icl-rocketry/Ricardo-PickleRick/Hardware/PickleRickv3.step

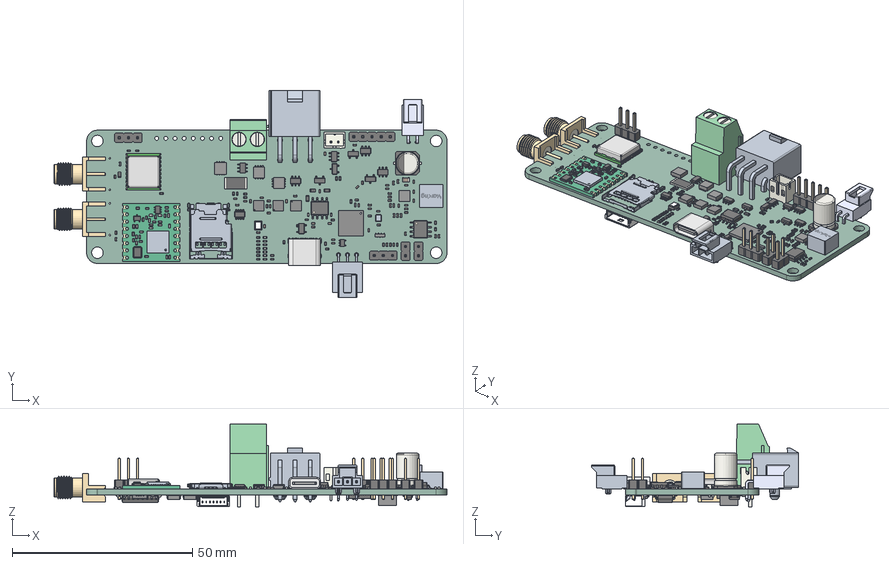
[picture p1: CAD file, 2026-01-28]
Hardware/PickleRickv3.step
109.0 x 57.4 x 23.0 mm
C_0402_1005Metric x 63
L_0402_1005Metric x 3
R_0402_1005Metric x 41
NX2016SA-40M-STD-CZS-3
LED_0402_1005Metric x 17
AL6050
C_0805_2012Metric
ASSEMBLY x 15
SOT_143
MAX-M8Q
CP_Elec_63x99
PinHeader_1x02_P254mm_Vertical x 2
R_0603_1608Metric x 4
SMA_Molex_73251-1153_EdgeMount_Horizontal x 2
SOT_23 x 5
PinHeader_1x03_P254mm_Vertical x 2
SOT_23_8
SOIC_8_39x49mm_P127mm x 2
PinHeader_1x05_P254mm_Vertical
LIS3DH
TSOT_23_6 x 5
RFM95W LoRa v15
ESP32-S3
MMC5983MA x 2
JST_B2B_PH_K
SOT_353_SC_70_5
ST1W008S4TR2000
TerminalBlock_Phoenix_MKDS_3_2_508_1x02_P508mm_Horizontal
DPS368XTSA1
R_2512_6332Metric
QFN-28-1EP_6x6mm_Pitch0.65mm
TO_277B_sp x 4
SOP_16_44x104mm_P127mm
RGV16
PickleRick_PCB
