icl-rocketry/Ricardo-PickleRick/PickleRick.step

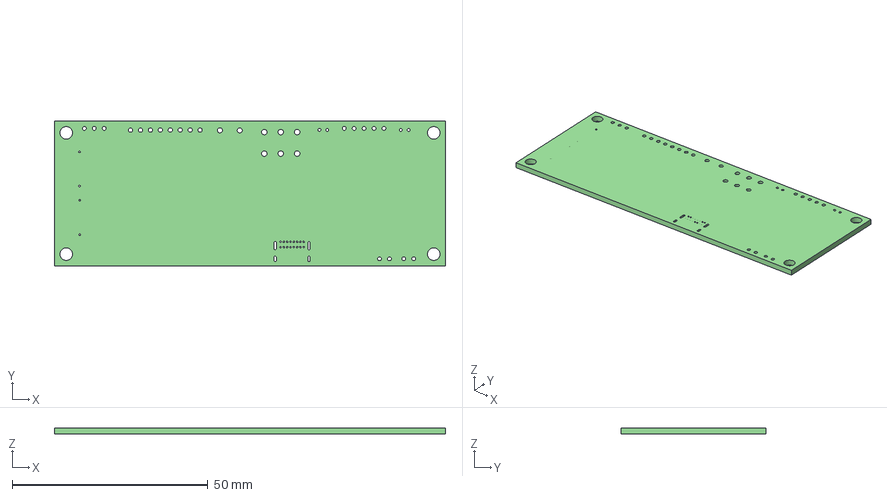
[picture p2: CAD file, 2022-03-22]
PickleRick.step
100.0 x 37.0 x 1.60 mm
