icl-rocketry/Ricardo-PickleRick/Hardware/PickleRick.kicad_pcb

## KiCad design Hardware/PickleRick.kicad_pcb (2026-06-24)

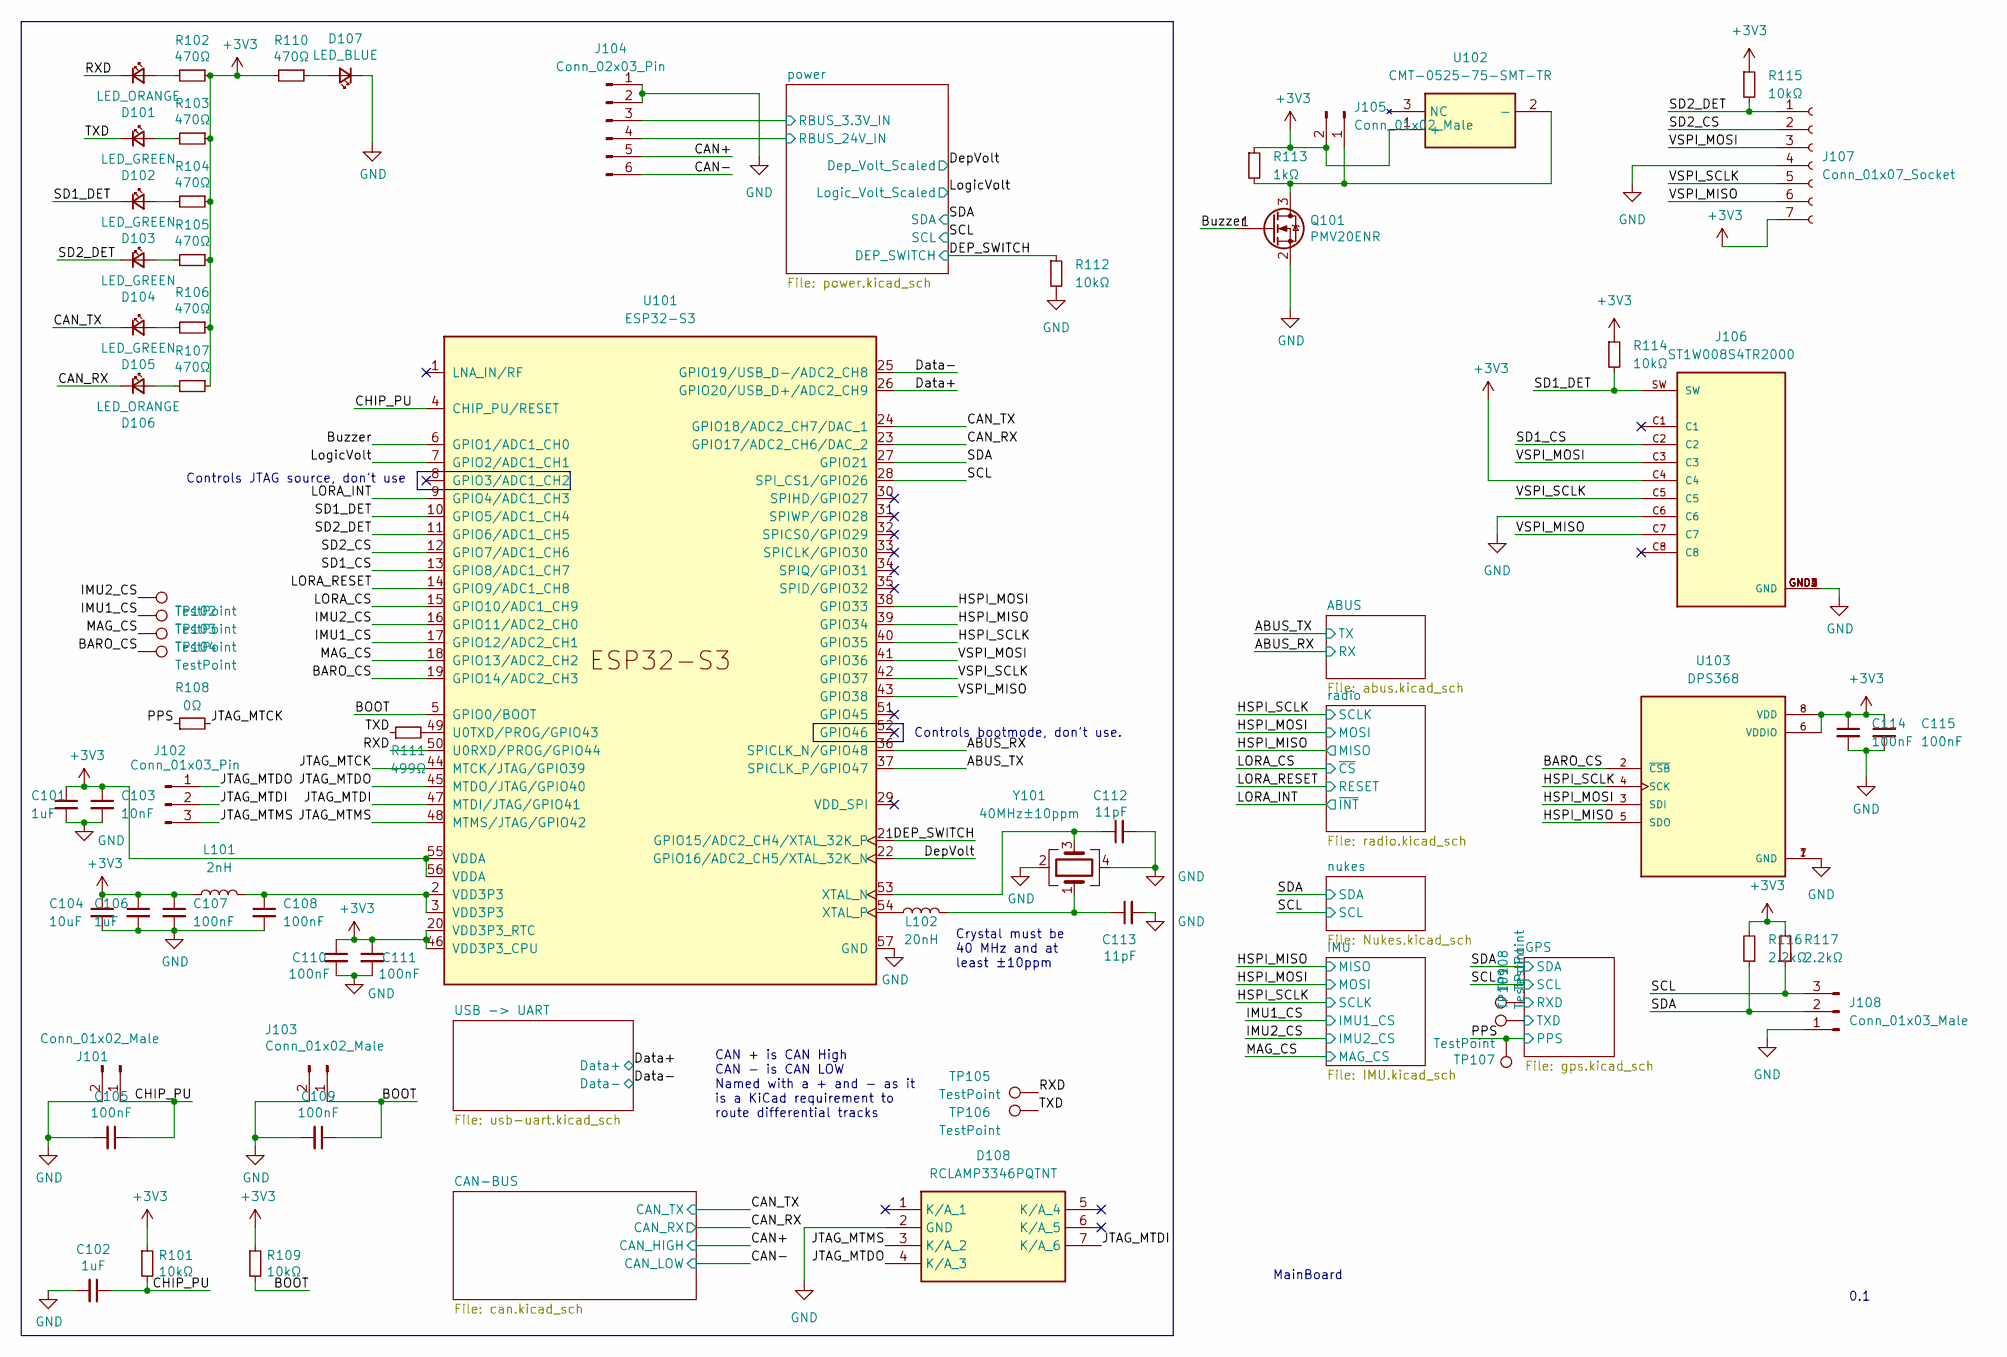
[picture p3: schematic PickleRick.kicad_sch]

Parts:
C101, C102, C106: 1uF; C_0402_1005Metric
C103: 10nF; C_0402_1005Metric
C104: 10uF; C_0402_1005Metric
C105, C107, C108, C109, C110, C111, C114, C115: 100nF; C_0402_1005Metric
C112, C113: 11pF; C_0402_1005Metric
D101, D106: LED_ORANGE; LED_0402_1005Metric
D102, D103, D104, D105: LED_GREEN; LED_0402_1005Metric
D107: LED_BLUE; LED_0402_1005Metric
D108: RCLAMP3346PQTNT; Mouser Part Number 947-RCLAMP3346PQTNT
J101, J103: Conn_01x02_Male; PinHeader_1x02_P2.54mm_Vertical
J102: Conn_01x03_Pin; PinHeader_1x03_P2.54mm_Vertical
J104: Conn_02x03_Pin; Molex_Mini-Fit_Jr_5566-06A_2x03_P4.20mm_Vertical
J105: Conn_01x02_Male; JST_PH_B2B-PH-K_1x02_P2.00mm_Vertical
J106: ST1W008S4TR2000; JAE_ST1W008S4TR2000; PARTREV 1
J107: Conn_01x07_Socket; Molex_Pico-Clasp_202396-0707_1x07-1MP_P1.00mm_Horizontal
J108: Conn_01x03_Male; PinHeader_1x03_P2.54mm_Vertical
L101: 2nH; L_0402_1005Metric
L102: 20nH; L_0402_1005Metric
Q101: PMV20ENR; SOT-23
R101, R109, R112, R114, R115: 10kΩ; R_0402_1005Metric
R102, R103, R104, R105, R106, R107, R110: 470Ω; R_0402_1005Metric
R108: 0Ω; R_0402_1005Metric
R111: 499Ω; R_0402_1005Metric
R113: 1kΩ; R_0402_1005Metric
R116, R117: 2.2kΩ; R_0402_1005Metric
TP101, TP102, TP103, TP104, TP105, TP106, TP107, TP108, TP109: TestPoint; TestPoint_Pad_D1.0mm
U101: ESP32-S3; QFN40P700X700X90-57N
U102: CMT-0525-75-SMT-TR; CMT052575SMTTR; Manufacturer_Part_Number CMT-0525-75-SMT-TR; Mouser Part Number 490-CMT-0525-75SMTTR
U103: DPS368; XDCR_DPS310
Y101: 40MHz±10ppm; Crystal_SMD_2016-4Pin_2.0x1.6mm; MPN R940000171

Connections:
+3V3: C101.1, C103.1, C104.1, C106.1, C107.1, C110.1, C111.1, C114.1, C115.1, J105.2, J106.C4, J107.7, L101.1, R101.1, R102.1, R103.1, R104.1, R105.1, R106.1, R107.1, R109.1, R110.2, R113.1, R114.1, R115.1, R116.2, R117.2, U101.20 (VDD3P3_RTC), U101.46 (VDD3P3_CPU), U101.55 (VDDA), U101.56 (VDDA), U102.1 (+), U103.6 (VDDIO), U103.8 (VDD); also elsewhere on the board
/ABUS_RX: U101.36 (SPICLK_N/GPIO48); also elsewhere on the board
/ABUS_TX: U101.37 (SPICLK_P/GPIO47); also elsewhere on the board
/BARO_CS: TP104.1, U101.19 (GPIO14/ADC2_CH3), U103.2 (~CSB)
/BOOT: C109.1, J103.1, R109.2, U101.5 (GPIO0/BOOT)
/Buzzer: Q101.1 (G), U101.6 (GPIO1/ADC1_CH0)
/CAN+: J104.5; also elsewhere on the board
/CAN-: J104.6; also elsewhere on the board
/CAN_RX: D106.1 (K), U101.23 (GPIO17/ADC2_CH6/DAC_2); also elsewhere on the board
/CAN_TX: D105.1 (K), U101.24 (GPIO18/ADC2_CH7/DAC_1); also elsewhere on the board
/CHIP_PU: C102.1, C105.1, J101.1, R101.2, U101.4 (CHIP_PU/RESET)
/DEP_SWITCH: R112.1, U101.21 (GPIO15/ADC2_CH4/XTAL_32K_P); also elsewhere on the board
/Data+: U101.26 (GPIO20/USB_D+/ADC2_CH9); also elsewhere on the board
/Data-: U101.25 (GPIO19/USB_D-/ADC2_CH8); also elsewhere on the board
/DepVolt: U101.22 (GPIO16/ADC2_CH5/XTAL_32K_N); also elsewhere on the board
/GPS/RXD: TP108.1; also elsewhere on the board
/GPS/TXD: TP109.1; also elsewhere on the board
/HSPI_MISO: U101.39 (GPIO34), U103.5 (SDO); also elsewhere on the board
/HSPI_MOSI: U101.38 (GPIO33), U103.3 (SDI); also elsewhere on the board
/HSPI_SCLK: U101.40 (GPIO35), U103.4 (SCK); also elsewhere on the board
/IMU1_CS: TP102.1, U101.17 (GPIO12/ADC2_CH1); also elsewhere on the board
/IMU2_CS: TP101.1, U101.16 (GPIO11/ADC2_CH0); also elsewhere on the board
/JTAG_MTCK: R108.2, U101.44 (MTCK/JTAG/GPIO39)
/JTAG_MTDI: D108.7 (K/A_6), J102.2, U101.47 (MTDI/JTAG/GPIO41)
/JTAG_MTDO: D108.4 (K/A_3), J102.1, U101.45 (MTDO/JTAG/GPIO40)
/JTAG_MTMS: D108.3 (K/A_2), J102.3, U101.48 (MTMS/JTAG/GPIO42)
/LORA_CS: U101.15 (GPIO10/ADC1_CH9); also elsewhere on the board
/LORA_INT: U101.9 (GPIO4/ADC1_CH3); also elsewhere on the board
/LORA_RESET: U101.14 (GPIO9/ADC1_CH8); also elsewhere on the board
/LogicVolt: U101.7 (GPIO2/ADC1_CH1); also elsewhere on the board
/MAG_CS: TP103.1, U101.18 (GPIO13/ADC2_CH2); also elsewhere on the board
/PPS: R108.1, TP107.1; also elsewhere on the board
/RXD: D101.1 (K), TP105.1, U101.50 (U0RXD/PROG/GPIO44)
/SCL: J108.3, R117.1, U101.28 (SPI_CS1/GPIO26); also elsewhere on the board
/SD1_CS: J106.C2, U101.13 (GPIO8/ADC1_CH7)
/SD1_DET: D103.1 (K), J106.SW, R114.2, U101.10 (GPIO5/ADC1_CH4)
/SD2_CS: J107.2, U101.12 (GPIO7/ADC1_CH6)
/SD2_DET: D104.1 (K), J107.1, R115.2, U101.11 (GPIO6/ADC1_CH5)
/SDA: J108.2, R116.1, U101.27 (GPIO21); also elsewhere on the board
/TXD: D102.1 (K), R111.1, TP106.1
/VSPI_MISO: J106.C7, J107.6, U101.43 (GPIO38)
/VSPI_MOSI: J106.C3, J107.3, U101.41 (GPIO36)
/VSPI_SCLK: J106.C5, J107.5, U101.42 (GPIO37)
/power/RBUS_3.3V_IN: J104.3; also elsewhere on the board
/power/RBUS_24V_IN: J104.4; also elsewhere on the board
GND: C101.2, C102.2, C103.2, C104.2, C105.2, C106.2, C107.2, C108.2, C109.2, C110.2, C111.2, C112.2, C113.2, C114.2, C115.2, D107.1 (K), D108.2 (GND), J101.2, J103.2, J104.1, J104.2, J106.C6, J106.GND1 (GND), J106.GND2 (GND), J106.GND3 (GND), J106.GND4 (GND), J107.4, J108.1, Q101.2 (S), R112.2, U101.57 (GND), U103.1 (GND), U103.7 (GND), Y101.2, Y101.4; also elsewhere on the board
unnamed: C108.1, L101.2, U101.2 (VDD3P3), U101.3 (VDD3P3)
unnamed: C113.1, L102.2, Y101.1
unnamed: D101.2 (A), R102.2
unnamed: D102.2 (A), R103.2
unnamed: D103.2 (A), R104.2
unnamed: D104.2 (A), R105.2
unnamed: D105.2 (A), R106.2
unnamed: D106.2 (A), R107.2
unnamed: D107.2 (A), R110.1
unnamed: J105.1, Q101.3 (D), R113.2, U102.2 (-)
unnamed: R111.2, U101.49 (U0TXD/PROG/GPIO43)
unnamed: C112.1, U101.53 (XTAL_N), Y101.3
unnamed: L102.1, U101.54 (XTAL_P)

Notes on the sheet:
Controls JTAG source, don't use
CAN + is CAN High CAN - is CAN LOW Named with a + and - as it is a KiCad requirement to route differential tracks
MainBoard
Controls bootmode, don't use.
0.1
Crystal must be 40 MHz and at least ±10ppm

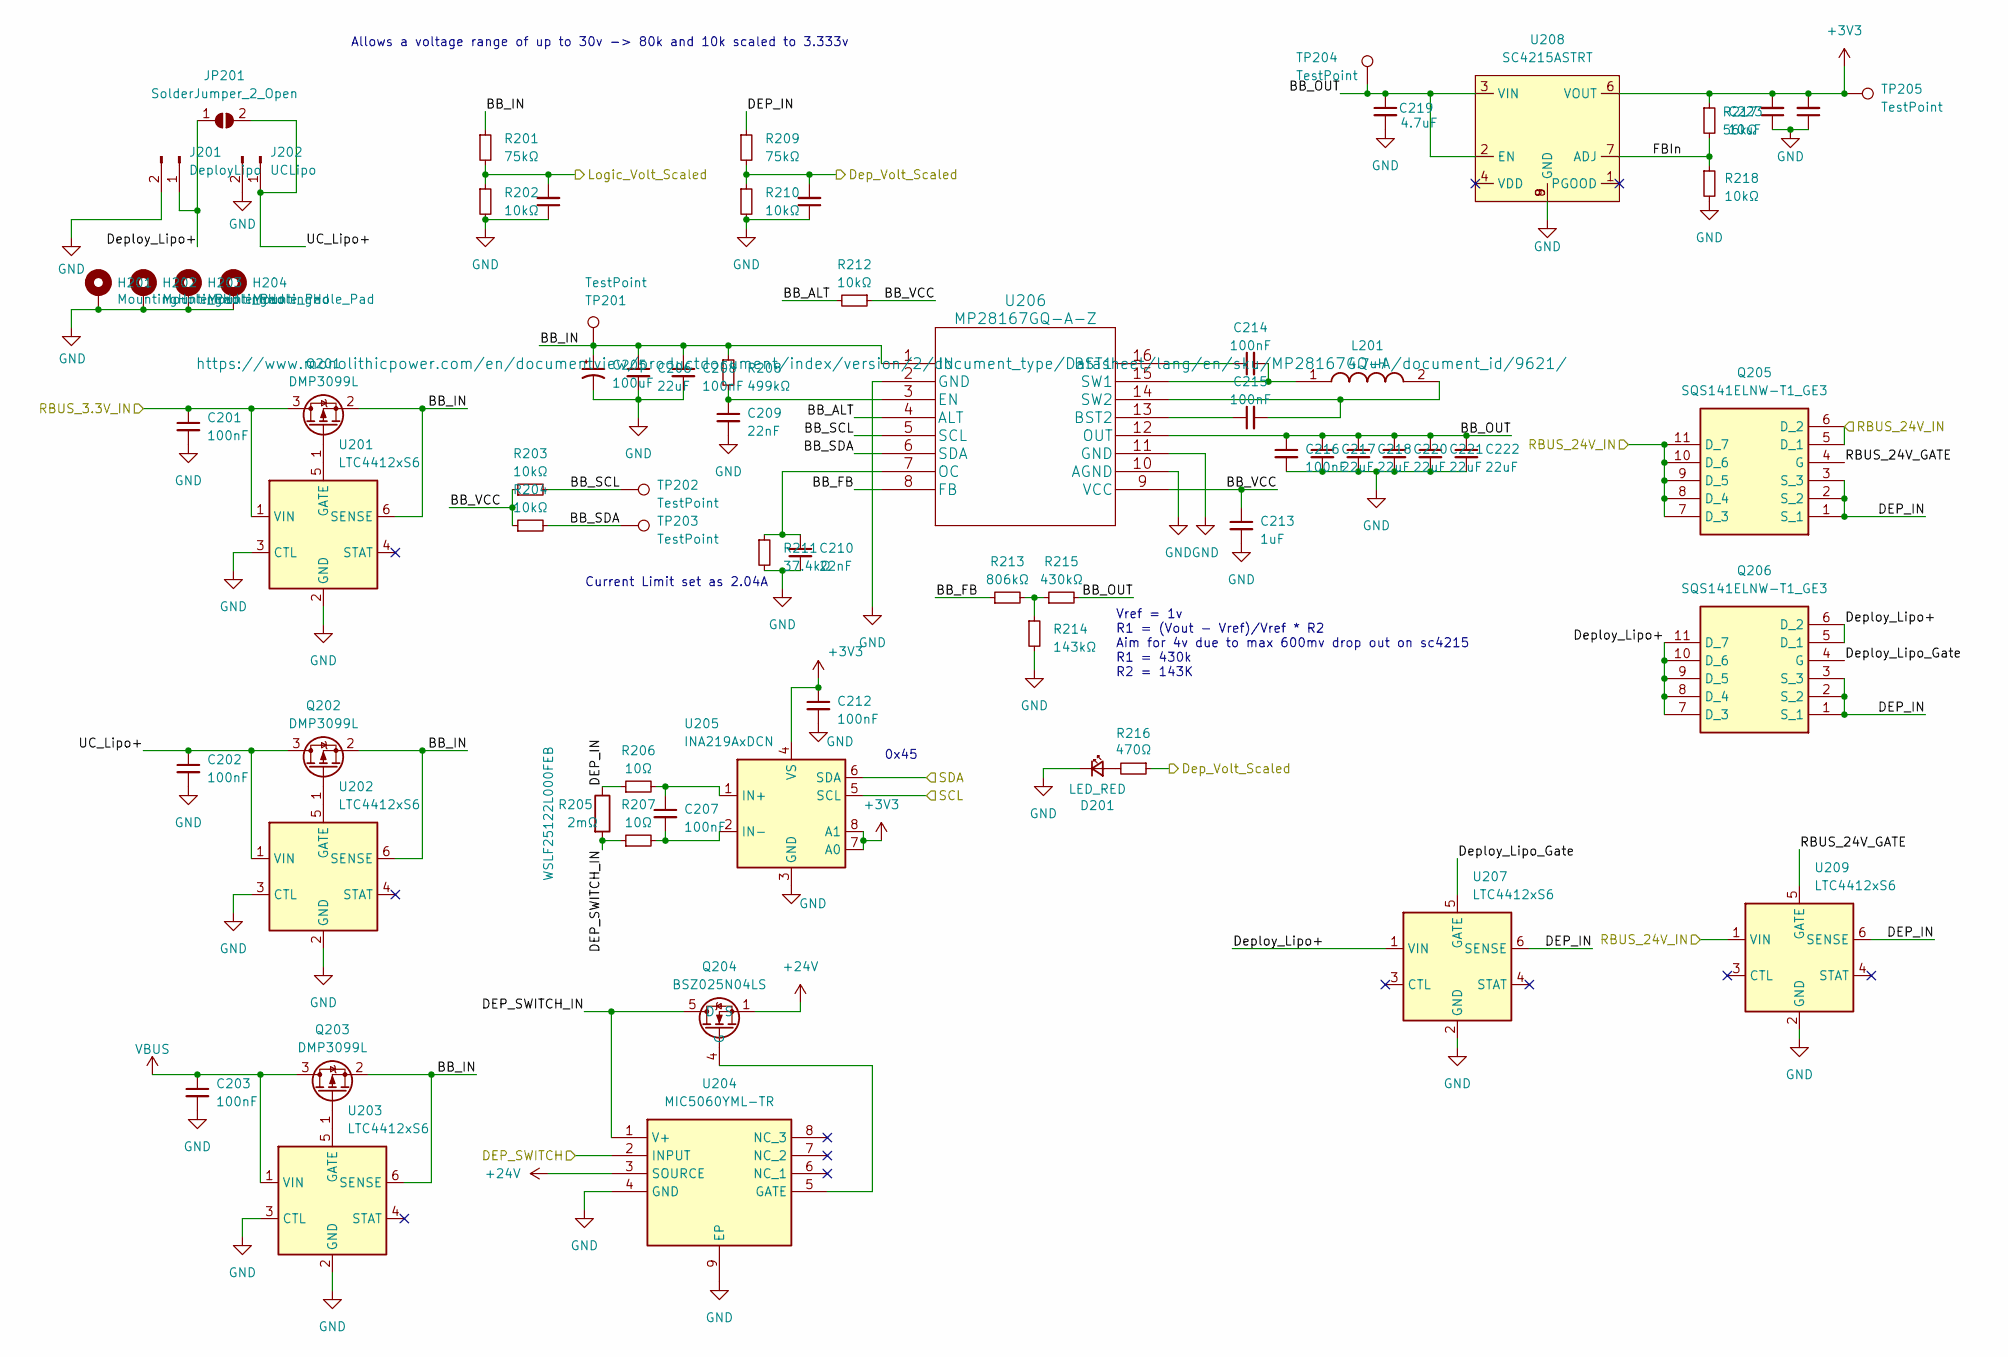
[picture p4: schematic power.kicad_sch]

Parts:
C201, C202, C203, C204, C207, C208, C211, C212, C214, C215, C216, C224: 100nF; C_0402_1005Metric
C205: 100uF; CP_Elec_6.3x9.9
C206: 22uF; C_0805_2012Metric
C209, C210: 22nF; C_0402_1005Metric
C213: 1uF; C_0402_1005Metric
C217, C218, C220, C221, C222: 22uF; C_0402_1005Metric
C219: 4.7uF; C_0402_1005Metric
C223: 10uF; C_0402_1005Metric
D201: LED_RED; LED_0402_1005Metric
H201, H202, H203, H204: MountingHole_Pad; MountingHole_3.2mm_M3_DIN965_Pad
J201: DeployLipo; TerminalBlock_Phoenix_MKDS-3-2-5.08_1x02_P5.08mm_Horizontal
J202: UCLipo; JST_PH_B2B-PH-K_1x02_P2.00mm_Vertical
JP201: SolderJumper_2_Open; SolderJumper-2_P1.3mm_Open_RoundedPad1.0x1.5mm
L201: 4.7uH; MPLAL60504R7; Manufacturer_Part_Number MPL-AL6050-4R7; Mouser Part Number 946-MPL-AL6050-4R7
Q201, Q202, Q203: DMP3099L; SOT-23
Q204: BSZ025N04LS; Manufacturer_Part_Number BSZ025N04LS; Mouser Part Number 726-BSZ025N04LS
Q205, Q206: SQS141ELNW-T1_GE3; SQS850ENT1_GE3; Manufacturer_Part_Number SQS141ELNW-T1_GE3; Mouser Part Number 78-SQS141ELNW-T1_GE3
R201, R209: 75kΩ; R_0402_1005Metric
R202, R203, R204, R210, R212, R218: 10kΩ; R_0402_1005Metric
R205: 2mΩ; R_2512_6332Metric_Pad1.40x3.35mm_HandSolder; Part Number WSLF25122L000FEB
R206, R207: 10Ω; R_0402_1005Metric
R208: 499kΩ; R_0402_1005Metric
R211: 37.4kΩ; R_0402_1005Metric
R213: 806kΩ; R_0402_1005Metric
R214: 143kΩ; R_0402_1005Metric
R215: 430kΩ; R_0402_1005Metric
R216: 470Ω; R_0402_1005Metric
R217: 56kΩ; R_0402_1005Metric
TP201, TP204, TP205: TestPoint; TestPoint_Pad_D2.0mm
TP202, TP203: TestPoint; TestPoint_Pad_D1.0mm
U201, U202, U203, U207, U209: LTC4412xS6; TSOT-23-6
U204: MIC5060YML-TR; SON65P300X300X100-9N-D; Manufacturer_Part_Number MIC5060YML-TR; Mouser Part Number 998-MIC5060YMLTR
U205: INA219AxDCN; SOT-23-8
U206: MP28167GQ-A-Z
U208: SC4215ASTRT; SOIC127P599X175-9N

Connections:
+3V3: C212.1, C223.2, C224.2, R217.1, TP205.1, U205.4 (VS), U205.7 (A0), U205.8 (A1), U208.6 (VOUT); also elsewhere on the board
+24V: Q204.1 (S), Q204.2 (S), Q204.3 (S), Q204.A1 (S), U204.3 (SOURCE); also elsewhere on the board
/DEP_SWITCH: U204.2 (INPUT); also elsewhere on the board
/DepVolt: C211.2, R209.2, R210.1, R216.1; also elsewhere on the board
/LogicVolt: C204.2, R201.2, R202.1; also elsewhere on the board
/SCL: U205.5 (SCL); also elsewhere on the board
/SDA: U205.6 (SDA); also elsewhere on the board
/power/BB_ALT: R212.2, U206.4 (ALT)
/power/BB_FB: R213.1, U206.8 (FB)
/power/BB_IN: C205.1, C206.1, C208.1, Q201.2 (S), Q202.2 (S), Q203.2 (S), R201.1, R208.1, TP201.1, U201.6 (SENSE), U202.6 (SENSE), U203.6 (SENSE), U206.1 (IN)
/power/BB_OUT: C216.1, C217.1, C218.1, C219.1, C220.1, C221.1, C222.1, R215.2, TP204.1, U206.12 (OUT), U208.2 (EN), U208.3 (VIN)
/power/BB_SCL: R203.2, TP202.1, U206.5 (SCL)
/power/BB_SDA: R204.2, TP203.1, U206.6 (SDA)
/power/BB_VCC: C213.1, R203.1, R204.1, R212.1, U206.9 (VCC)
/power/DEP_IN: Q205.1 (S_1), Q205.2 (S_2), Q205.3 (S_3), Q206.1 (S_1), Q206.2 (S_2), Q206.3 (S_3), R205.1, R206.1, R209.1, U207.6 (SENSE), U209.6 (SENSE)
/power/DEP_SWITCH_IN: Q204.5 (D), Q204.6 (D), Q204.7 (D), Q204.8 (D), Q204.A5 (D), R205.2, R207.1, U204.1 (V+)
/power/Deploy_Lipo+: J201.1, JP201.1 (A), Q206.5 (D_1), Q206.6 (D_2), Q206.7 (D_3), Q206.8 (D_4), Q206.9 (D_5), Q206.10 (D_6), Q206.11 (D_7), U207.1 (VIN)
/power/Deploy_Lipo_Gate: Q206.4 (G), U207.5 (GATE)
/power/FBIn: R217.2, R218.1, U208.7 (ADJ)
/power/RBUS_3.3V_IN: C201.1, Q201.3 (D), U201.1 (VIN); also elsewhere on the board
/power/RBUS_24V_GATE: Q205.4 (G), U209.5 (GATE)
/power/RBUS_24V_IN: Q205.5 (D_1), Q205.6 (D_2), Q205.7 (D_3), Q205.8 (D_4), Q205.9 (D_5), Q205.10 (D_6), Q205.11 (D_7), U209.1 (VIN); also elsewhere on the board
/power/UC_Lipo+: C202.1, J202.1, JP201.2 (B), Q202.3 (D), U202.1 (VIN)
GND: C201.2, C202.2, C203.2, C204.1, C205.2, C206.2, C208.2, C209.2, C210.2, C211.1, C212.2, C213.2, C216.2, C217.2, C218.2, C219.2, C220.2, C221.2, C222.2, C223.1, C224.1, D201.1 (K), H201.1, H202.1, H203.1, H204.1, J201.2, J202.2, R202.2, R210.2, R211.2, R214.2, R218.2, U201.2 (GND), U201.3 (CTL), U202.2 (GND), U202.3 (CTL), U203.2 (GND), U203.3 (CTL), U204.4 (GND), U204.9 (EP), U205.3 (GND), U206.2 (GND), U206.10 (AGND), U206.11 (GND), U207.2 (GND), U208.8 (GND), U208.9 (GND), U209.2 (GND); also elsewhere on the board
unnamed: D201.2 (A), R216.2
unnamed: Q201.1 (G), U201.5 (GATE)
unnamed: Q202.1 (G), U202.5 (GATE)
unnamed: Q203.1 (G), U203.5 (GATE)
unnamed: Q204.4 (G), U204.5 (GATE)
unnamed: R213.2, R214.1, R215.1
unnamed: C207.1, R206.2, U205.1 (IN+)
unnamed: C207.2, R207.2, U205.2 (IN-)
unnamed: C214.1, U206.16 (BST1)
unnamed: C215.1, U206.13 (BST2)
unnamed: C209.1, R208.2, U206.3 (EN)
unnamed: C210.1, R211.1, U206.7 (OC)
unnamed: C214.2, L201.1, U206.15 (SW1)
unnamed: C215.2, L201.2, U206.14 (SW2)
VBUS: C203.1, Q203.3 (D), U203.1 (VIN); also elsewhere on the board

Notes on the sheet:
0x45
Allows a voltage range of up to 30v -> 80k and 10k scaled to 3.333v
Vref = 1v R1 = (Vout - Vref)/Vref * R2 Aim for 4v due to max 600mv drop out on sc4215 R1 = 430k R2 = 143K
Current Limit set as 2.04A

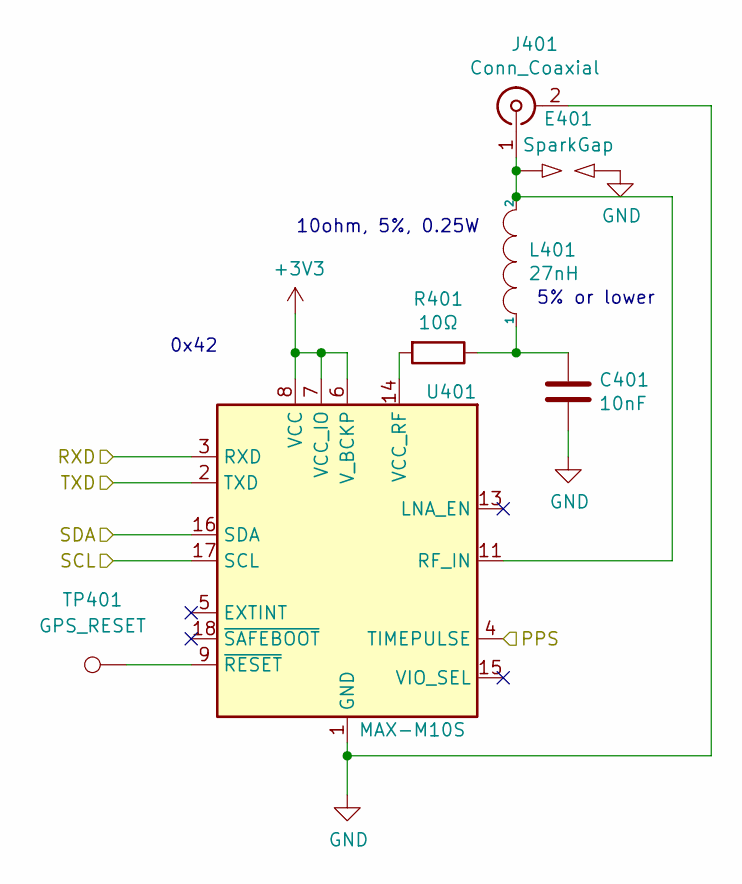
[picture p5: schematic gps.kicad_sch]

Parts:
C401: 10nF; C_0402_1005Metric
E401: SparkGap; Spark_Gap
J401: Conn_Coaxial; SMA_Molex_73251-1153_EdgeMount_Horizontal
L401: 27nH; L_0402_1005Metric; Part LQG15HZ27NH02D
R401: 10Ω; R_0603_1608Metric
TP401: GPS_RESET; TestPoint_Pad_D1.0mm
U401: MAX-M10S; ublox_MAX

Connections:
+3V3: U401.6 (V_BCKP), U401.7 (VCC_IO), U401.8 (VCC); also elsewhere on the board
/GPS/RXD: U401.3 (RXD); also elsewhere on the board
/GPS/TXD: U401.2 (TXD); also elsewhere on the board
/PPS: U401.4 (TIMEPULSE); also elsewhere on the board
/SCL: U401.17 (SCL); also elsewhere on the board
/SDA: U401.16 (SDA); also elsewhere on the board
GND: C401.2, E401.2, J401.2 (Ext), U401.1 (GND), U401.10 (GND), U401.12 (GND); also elsewhere on the board
unnamed: C401.1, L401.1, R401.1
unnamed: E401.1, J401.1 (In), L401.2, U401.11 (RF_IN)
unnamed: R401.2, U401.14 (VCC_RF)
unnamed: TP401.1, U401.9 (~RESET)

Notes on the sheet:
5% or lower
0x42
10ohm, 5%, 0.25W

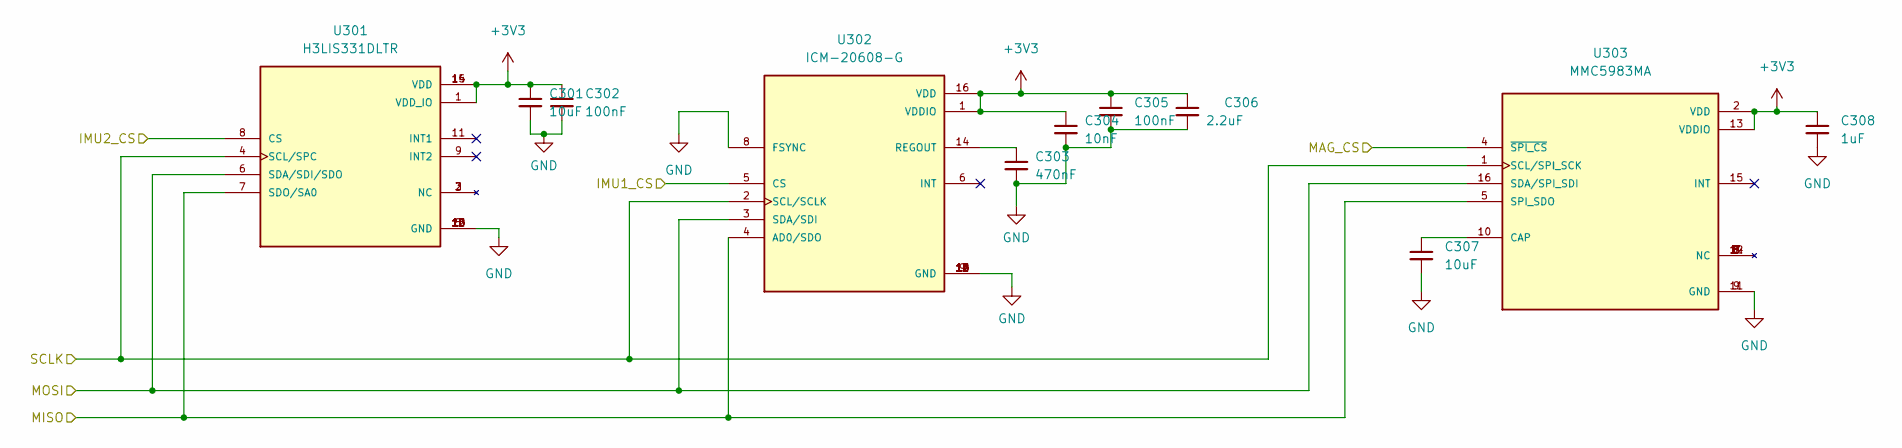
[picture p6: schematic IMU.kicad_sch]

Parts:
C301, C307: 10uF; C_0402_1005Metric
C302, C305: 100nF; C_0402_1005Metric
C303: 470nF; C_0402_1005Metric
C304: 10nF; C_0402_1005Metric
C306: 2.2uF; C_0402_1005Metric
C308: 1uF; C_0402_1005Metric
U301: H3LIS331DLTR; QFN300X300X100-16N; PARTREV 2
U302: ICM-20608-G; PQFN50P300X300X80-16N; PARTREV 1.0
U303: MMC5983MA; PQFN50P300X300X100-16N; PARTREV A

Connections:
+3V3: C301.1, C302.1, C304.1, C305.1, C306.1, C308.1, U301.1 (VDD_IO), U301.14 (VDD), U301.15 (VDD), U302.1 (VDDIO), U302.16 (VDD), U303.2 (VDD), U303.13 (VDDIO); also elsewhere on the board
/HSPI_MISO: U301.7 (SDO/SA0), U302.4 (AD0/SDO), U303.5 (SPI_SDO); also elsewhere on the board
/HSPI_MOSI: U301.6 (SDA/SDI/SDO), U302.3 (SDA/SDI), U303.16 (SDA/SPI_SDI); also elsewhere on the board
/HSPI_SCLK: U301.4 (SCL/SPC), U302.2 (SCL/SCLK), U303.1 (SCL/SPI_SCK); also elsewhere on the board
/IMU1_CS: U302.5 (CS); also elsewhere on the board
/IMU2_CS: U301.8 (CS); also elsewhere on the board
/MAG_CS: U303.4 (~SPI_CS); also elsewhere on the board
GND: C301.2, C302.2, C303.2, C304.2, C305.2, C306.2, C307.2, C308.2, U301.5 (GND), U301.10 (GND), U301.12 (GND), U301.13 (GND), U301.16 (GND), U302.8 (FSYNC), U302.9 (GND), U302.10 (GND), U302.11 (GND), U302.12 (GND), U302.13 (GND), U302.15 (GND), U303.9 (GND), U303.11 (GND); also elsewhere on the board
unnamed: C303.1, U302.14 (REGOUT)
unnamed: C307.1, U303.10 (CAP)

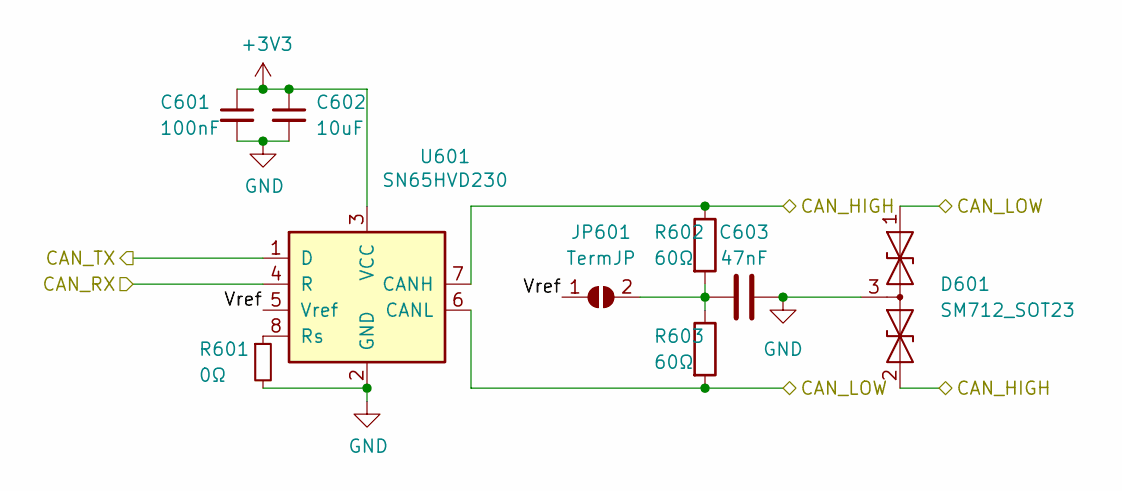
[picture p7: schematic can.kicad_sch]

Parts:
C601: 100nF; C_0402_1005Metric
C602: 10uF; C_0402_1005Metric
C603: 47nF; C_0402_1005Metric
D601: SM712_SOT23; SOT-23
JP601: TermJP; SmallerSolderJP
R601: 0Ω; R_0603_1608Metric
R602, R603: 60Ω; R_0603_1608Metric
U601: SN65HVD230; SOIC-8_3.9x4.9mm_P1.27mm

Connections:
+3V3: C601.1, C602.1, U601.3 (VCC); also elsewhere on the board
/CAN+: D601.2 (A2), R602.1, U601.7 (CANH); also elsewhere on the board
/CAN-: D601.1 (A1), R603.2, U601.6 (CANL); also elsewhere on the board
/CAN-BUS/Vref: JP601.1 (A), U601.5 (Vref)
/CAN_RX: U601.4 (R); also elsewhere on the board
/CAN_TX: U601.1 (D); also elsewhere on the board
GND: C601.2, C602.2, C603.2, D601.3 (common), R601.2, U601.2 (GND); also elsewhere on the board
unnamed: C603.1, JP601.2 (B), R602.2, R603.1
unnamed: R601.1, U601.8 (Rs)

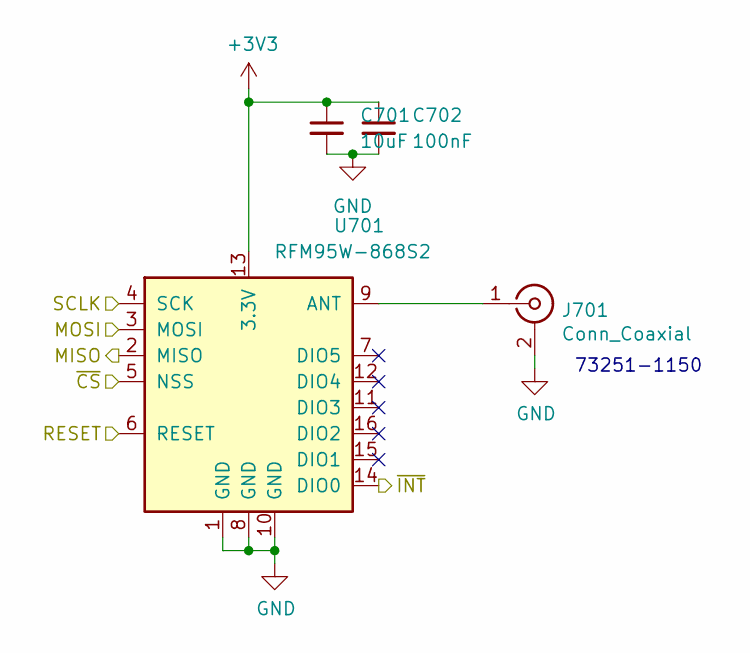
[picture p8: schematic radio.kicad_sch]

Parts:
C701: 10uF; C_0402_1005Metric
C702: 100nF; C_0402_1005Metric
J701: Conn_Coaxial; SMA_Molex_73251-1153_EdgeMount_Horizontal
U701: RFM95W-868S2; HOPERF_RFM9XW_SMD

Connections:
+3V3: C701.1, C702.1, U701.13 (3.3V); also elsewhere on the board
/HSPI_MISO: U701.2 (MISO); also elsewhere on the board
/HSPI_MOSI: U701.3 (MOSI); also elsewhere on the board
/HSPI_SCLK: U701.4 (SCK); also elsewhere on the board
/LORA_CS: U701.5 (NSS); also elsewhere on the board
/LORA_INT: U701.14 (DIO0); also elsewhere on the board
/LORA_RESET: U701.6 (RESET); also elsewhere on the board
GND: C701.2, C702.2, J701.2 (Ext), U701.1 (GND), U701.8 (GND), U701.10 (GND); also elsewhere on the board
unnamed: J701.1 (In), U701.9 (ANT)

Notes on the sheet:
73251-1150

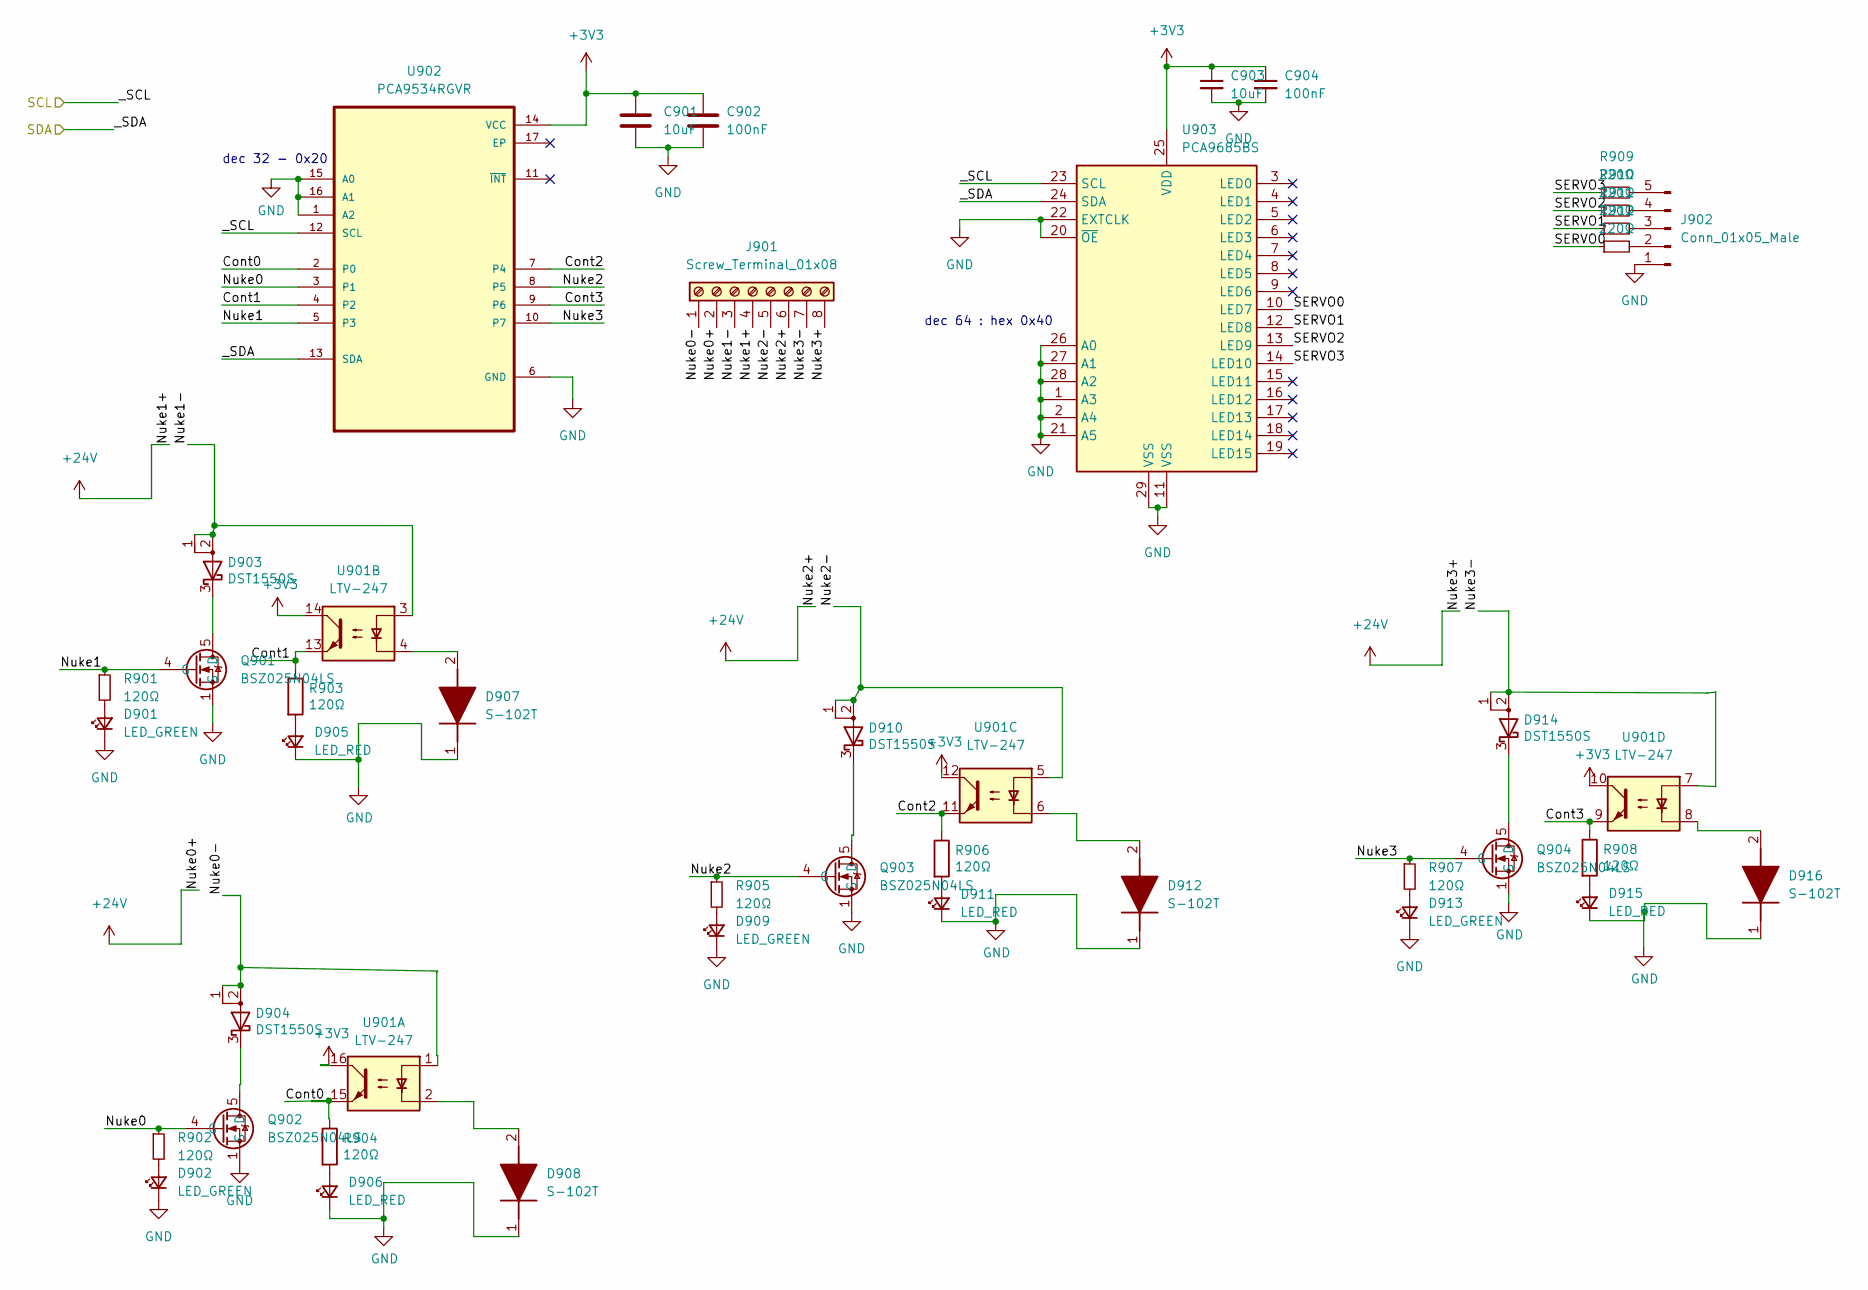
[picture p9: schematic Nukes.kicad_sch]

Parts:
C901, C903: 10uF; C_0402_1005Metric
C902, C904: 100nF; C_0402_1005Metric
D901, D902, D909, D913: LED_GREEN; LED_0402_1005Metric
D903, D904, D910, D914: DST1550S; TO-277B
D905, D906, D911, D915: LED_RED; LED_0402_1005Metric
D907, D908, D912, D916: S-102T; SODFL3516X70N; Manufacturer_Part_Number S-102T; Mouser Part Number 954-S-102T
J901: Screw_Terminal_01x08; TerminalBlock_TE_282834-8_1x08_P2.54mm_Horizontal
J902: Conn_01x05_Male; PinHeader_1x05_P2.54mm_Vertical
Q901, Q902, Q903, Q904: BSZ025N04LS; Manufacturer_Part_Number BSZ025N04LS; Mouser Part Number 726-BSZ025N04LS
R901, R902, R903, R904, R905, R906, R907, R908: 120Ω; R_0402_1005Metric
R909, R910, R911, R912: 220Ω; R_0402_1005Metric
U901: LTV-247; SOP-16_4.4x10.4mm_P1.27mm
U902: PCA9534RGVR; QFN65P400X400X100-17N
U903: PCA9685BS; QFN-28-1EP_6x6mm_P0.65mm_EP4.25x4.25mm

Connections:
+3V3: C901.1, C902.1, C903.1, C904.1, U901.10, U901.12, U901.14, U901.16, U902.14 (VCC), U903.25 (VDD); also elsewhere on the board
+24V: J901.2, J901.4, J901.6, J901.8; also elsewhere on the board
/SCL: U902.12 (SCL), U903.23 (SCL); also elsewhere on the board
/SDA: U902.13 (SDA), U903.24 (SDA); also elsewhere on the board
/nukes/Cont0: R904.1, U901.15, U902.2 (P0)
/nukes/Cont1: R903.1, U901.13, U902.4 (P2)
/nukes/Cont2: R906.1, U901.11, U902.7 (P4)
/nukes/Cont3: R908.1, U901.9, U902.9 (P6)
/nukes/Nuke0: Q902.4 (G), R902.1, U902.3 (P1)
/nukes/Nuke0-: D904.1 (A), D904.2 (A), J901.1, U901.1
/nukes/Nuke1: Q901.4 (G), R901.1, U902.5 (P3)
/nukes/Nuke1-: D903.1 (A), D903.2 (A), J901.3, U901.3
/nukes/Nuke2: Q903.4 (G), R905.1, U902.8 (P5)
/nukes/Nuke2-: D910.1 (A), D910.2 (A), J901.5, U901.5
/nukes/Nuke3: Q904.4 (G), R907.1, U902.10 (P7)
/nukes/Nuke3-: D914.1 (A), D914.2 (A), J901.7, U901.7
/nukes/SERVO0: R912.1, U903.10 (LED7)
/nukes/SERVO1: R911.1, U903.12 (LED8)
/nukes/SERVO2: R910.1, U903.13 (LED9)
/nukes/SERVO3: R909.1, U903.14 (LED10)
GND: C901.2, C902.2, C903.2, C904.2, D901.1 (K), D902.1 (K), D905.1 (K), D906.1 (K), D907.1 (K), D908.1 (K), D909.1 (K), D911.1 (K), D912.1 (K), D913.1 (K), D915.1 (K), D916.1 (K), J902.1, Q901.1 (S), Q901.2 (S), Q901.3 (S), Q901.A1 (S), Q902.1 (S), Q902.2 (S), Q902.3 (S), Q902.A1 (S), Q903.1 (S), Q903.2 (S), Q903.3 (S), Q903.A1 (S), Q904.1 (S), Q904.2 (S), Q904.3 (S), Q904.A1 (S), U902.1 (A2), U902.6 (GND), U902.15 (A0), U902.16 (A1), U903.1 (A3), U903.2 (A4), U903.11 (VSS), U903.20 (~OE), U903.21 (A5), U903.22 (EXTCLK), U903.26 (A0), U903.27 (A1), U903.28 (A2), U903.29 (VSS); also elsewhere on the board
unnamed: D901.2 (A), R901.2
unnamed: D902.2 (A), R902.2
unnamed: D903.3 (K), Q901.5 (D), Q901.6 (D), Q901.7 (D), Q901.8 (D), Q901.A5 (D)
unnamed: D904.3 (K), Q902.5 (D), Q902.6 (D), Q902.7 (D), Q902.8 (D), Q902.A5 (D)
unnamed: D905.2 (A), R903.2
unnamed: D906.2 (A), R904.2
unnamed: D907.2 (A), U901.4
unnamed: D908.2 (A), U901.2
unnamed: D909.2 (A), R905.2
unnamed: D910.3 (K), Q903.5 (D), Q903.6 (D), Q903.7 (D), Q903.8 (D), Q903.A5 (D)
unnamed: D911.2 (A), R906.2
unnamed: D912.2 (A), U901.6
unnamed: D913.2 (A), R907.2
unnamed: D914.3 (K), Q904.5 (D), Q904.6 (D), Q904.7 (D), Q904.8 (D), Q904.A5 (D)
unnamed: D915.2 (A), R908.2
unnamed: D916.2 (A), U901.8
unnamed: J902.2, R912.2
unnamed: J902.3, R911.2
unnamed: J902.4, R910.2
unnamed: J902.5, R909.2

Notes on the sheet:
dec 32 - 0x20
dec 64 : hex 0x40

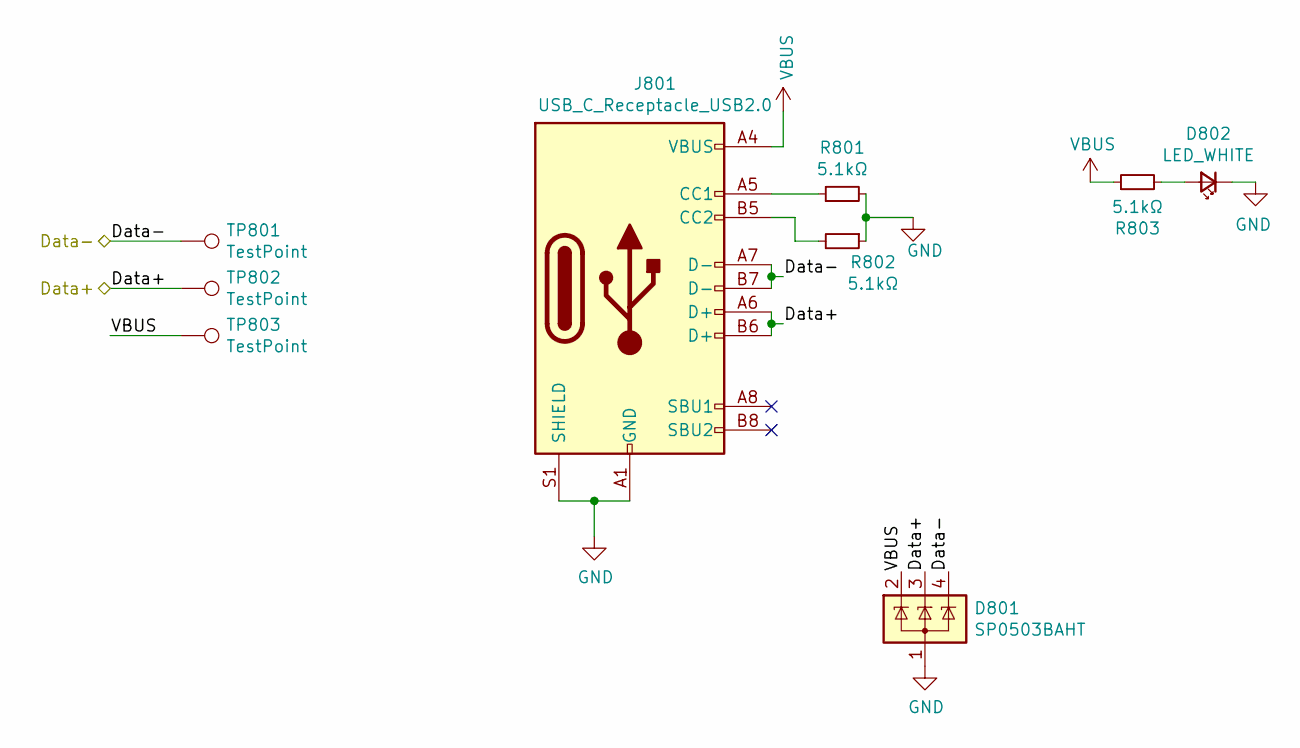
[picture p10: schematic usb-uart.kicad_sch]

Parts:
D801: SP0503BAHT; SOT-143
D802: LED_WHITE; LED_0402_1005Metric
J801: USB_C_Receptacle_USB2.0; USB_C_Receptacle_Palconn_UTC16-G
R801, R802, R803: 5.1kΩ; R_0402_1005Metric
TP801, TP802, TP803: TestPoint; TestPoint_Pad_D1.0mm

Connections:
/Data+: D801.3 (K), J801.A6 (D+), J801.B6 (D+), TP802.1; also elsewhere on the board
/Data-: D801.4 (K), J801.A7 (D-), J801.B7 (D-), TP801.1; also elsewhere on the board
GND: D801.1 (A), D802.1 (K), J801.A1 (GND), J801.A12 (GND), J801.B1 (GND), J801.B12 (GND), J801.S1 (SHIELD), R801.2, R802.1; also elsewhere on the board
unnamed: D802.2 (A), R803.2
unnamed: J801.A5 (CC1), R801.1
unnamed: J801.B5 (CC2), R802.2
VBUS: D801.2 (K), J801.A4 (VBUS), J801.A9 (VBUS), J801.B4 (VBUS), J801.B9 (VBUS), R803.1, TP803.1; also elsewhere on the board
