icl-rocketry/Ricardo-PickleRick/Hardware/PickleRick.kicad_pcb

## KiCad design Hardware/PickleRick.kicad_pcb (continued)

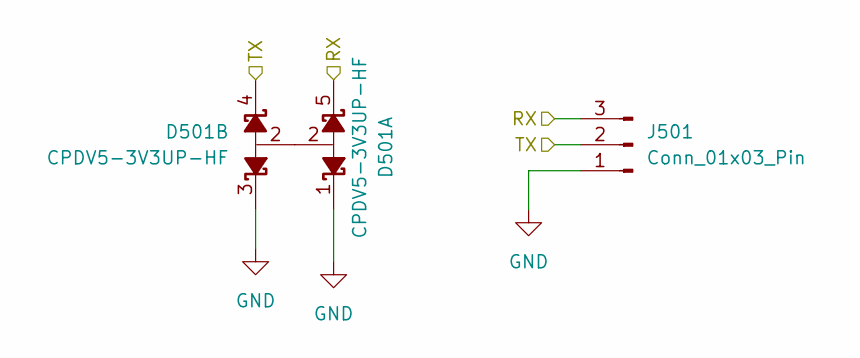
[picture p11: schematic abus.kicad_sch]

Parts:
D501: CPDV5-3V3UP-HF; SOT-353_SC-70-5
J501: Conn_01x03_Pin; Molex_Nano-Fit_105313-xx03_1x03_P2.50mm_Horizontal

Connections:
/ABUS_RX: D501.5, J501.3; also elsewhere on the board
/ABUS_TX: D501.4, J501.2; also elsewhere on the board
GND: D501.1, D501.3, J501.1; also elsewhere on the board

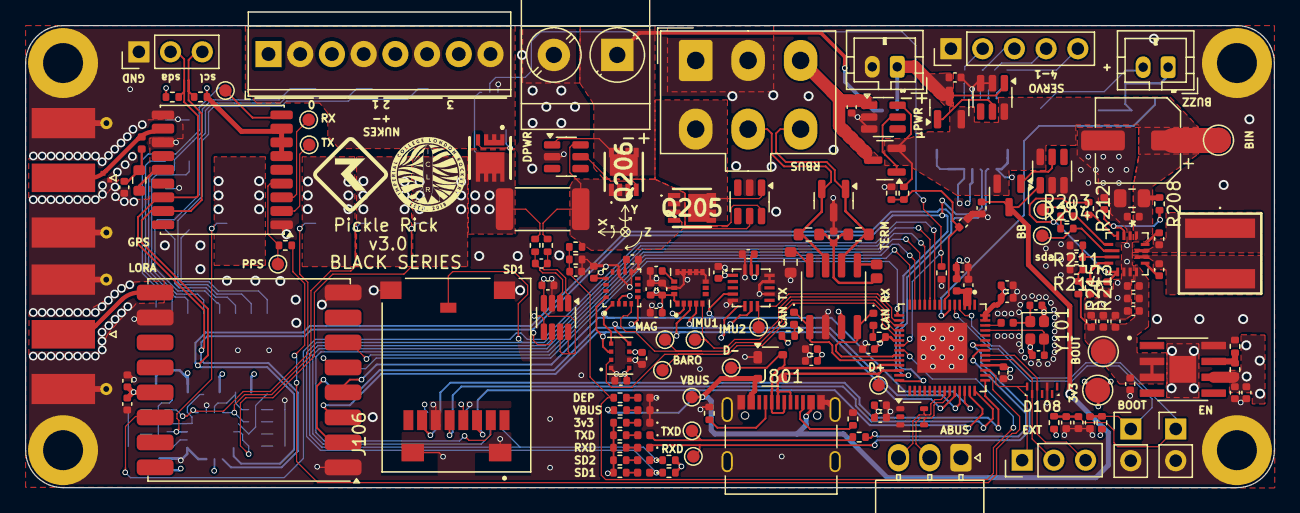
[picture p12: board PickleRick.kicad_pcb from above]

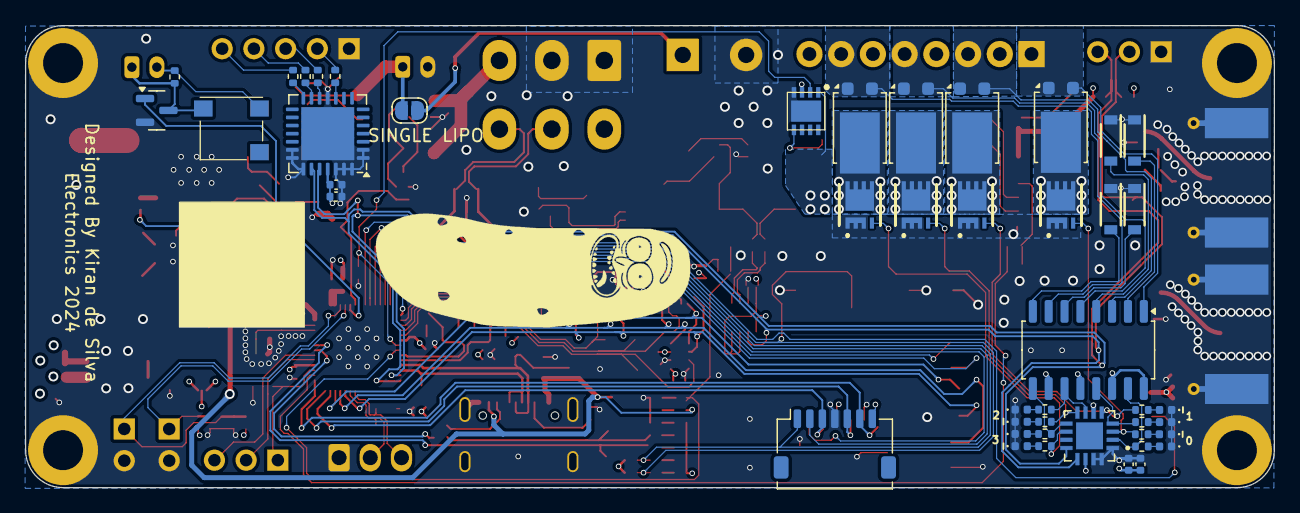
[picture p13: board PickleRick.kicad_pcb from below]

Board: 6 copper layers, 100.0 x 37.0 mm, 219 parts (45 on the bottom side), 138 nets.

Other parts of the board:
G**: orientation_marker
