icl-rocketry/Ricardo-PickleRick/Firmware/src/GNC/GNCController.cpp

#include "GNC/GNCController.h"
#include "Config/general_config.h"
#include "Config/loggerhandler_config.h"

#include <cmath>

#include <libriccore/riccorelogging.h>

// ------------Code for the throttling tests-----------------
namespace {
struct ThrottleProfileStep {
    float demand;
    unsigned long duration_ms;
};

constexpr ThrottleProfileStep kThrottleProfile[] = {
    //check in general config whether the demand is in Newtons or in power percent and convert accordingly in the code below
    {13.0f, 20000},  {0.0f, 8000},
    {1.0f, 8000},   {0.0f, 40000},
};

constexpr uint8_t kThrottleProfileStepCount =
    static_cast<uint8_t>(sizeof(kThrottleProfile) / sizeof(kThrottleProfile[0]));

constexpr float kThrottleProfileNominalBattV = 15.600f;
constexpr float kThrottleProfileVoltageExponent = 0.95f;
constexpr float kThrottleProfileMinValidBattV = 12.0f;
constexpr float kThrottleProfileMinVoltageScale = 0.8f;
constexpr float kThrottleProfileMaxVoltageScale = 1.1f;
constexpr float kThrottleProfileMaxThrustN = 31.1f;
constexpr float kThrottleProfileThrustLinearisationExponent = 0.7f;

float calculateThrottleProfileVoltageScale(float filtered_battery_voltage, bool fresh)
{
    if (!fresh || filtered_battery_voltage <= kThrottleProfileMinValidBattV)
    {
        return 1.0f;
    }

    return std::clamp(
        powf(kThrottleProfileNominalBattV / filtered_battery_voltage,
             kThrottleProfileVoltageExponent),
        kThrottleProfileMinVoltageScale,
        kThrottleProfileMaxVoltageScale);
}

float clampThrottlePercent(float command)
{
    if (command < 0.0f)
    {
        return 0.0f;
    }
    if (command > 100.0f)
    {
        return 100.0f;
    }
    return command;
}

float throttleProfileDemandToDesiredThrustPercent(float demand)
{
    if constexpr (GeneralConfig::ThrottleRampProfileCommandsThrustNewtons)
    {
        return demand * 100.0f / kThrottleProfileMaxThrustN;
    }

    return demand;
}

float desiredThrustPercentToPwmPercent(float desired_thrust_percent)
{
    desired_thrust_percent = clampThrottlePercent(desired_thrust_percent);

    return 100.0f * powf(desired_thrust_percent / 100.0f,
                         kThrottleProfileThrustLinearisationExponent);
}
}



void GNCController::setup() {

    m_pd.setup();

}

void GNCController::start() {

    m_controller_start_time = millis();
    m_throttle_profile_step_start_time = m_controller_start_time;
    m_throttle_profile_step = 0;
    m_voltage_scale = 1.0f;
    m_output << 0.0f, 0.0f, 0.0f, 0.0f;
    sendArmingCommands();
    m_pd.reset();
    
}

void GNCController::setBatteryVoltage(float batt_V, bool fresh)
{
    m_batt_V = batt_V;
    m_batt_fresh = fresh;
}

void GNCController::setPositionTarget(const Eigen::Vector3f& position,
                                      const Eigen::Vector3f& velocity,
                                      const Eigen::Vector3f& acceleration)
{
    m_pd.setPositionTarget(position, velocity, acceleration);
}

void GNCController::setPositionControlEnabled(bool enabled)
{
    m_pd.setPositionControlEnabled(enabled);
}

void GNCController::setManualOutput(const Eigen::Vector4f& output, bool actuate)
{
    m_output = output;

    const unsigned long now = millis();
    if (actuate && now - m_previousSampleTime >= m_actuationDelta) {
        m_previousSampleTime = now;
        sendActuationCommands(m_output);
    }
}

void GNCController::update(Eigen::Quaterniond q, 
                           Eigen::Vector3f angular_rates, 
                           Eigen::Vector3f position, 
                           Eigen::Vector3f velocity,
                           bool actuate)
{

    if (millis() - m_previousSampleTime >= m_actuationDelta) {

        m_previousSampleTime = millis();

        q.normalize();
        const Eigen::Vector3f controller_position = position;
        const Eigen::Vector3f controller_velocity = velocity;

        m_input << static_cast<float>(q.w()),
                   static_cast<float>(q.x()),
                   static_cast<float>(q.y()),
                   static_cast<float>(q.z()),
                   angular_rates(0),
                   angular_rates(1),
                   angular_rates(2);

        m_pd.update(q, angular_rates, controller_position, controller_velocity, m_batt_V, m_batt_fresh);
        m_output = m_pd.getOutputValues();
        m_voltage_scale = m_pd.getVoltageScale();
        if (actuate) {

            sendActuationCommands(m_output);

        }

    }

}

void GNCController::updateThrottleProfileTest(bool actuate)
{
    const unsigned long now = millis();

    if (now - m_previousSampleTime < m_actuationDelta)
    {
        return;
    }

    m_previousSampleTime = now;

    while (m_throttle_profile_step < kThrottleProfileStepCount &&
           now - m_throttle_profile_step_start_time >= kThrottleProfile[m_throttle_profile_step].duration_ms)
    {
        m_throttle_profile_step_start_time += kThrottleProfile[m_throttle_profile_step].duration_ms;
        m_throttle_profile_step++;
    }

    float desired_thrust_percent = 0.0f;
    if (m_throttle_profile_step < kThrottleProfileStepCount)
    {
        desired_thrust_percent =
            throttleProfileDemandToDesiredThrustPercent(kThrottleProfile[m_throttle_profile_step].demand);
    }

    m_voltage_scale = calculateThrottleProfileVoltageScale(m_batt_V, m_batt_fresh);
    const float compensated_thrust_percent = clampThrottlePercent(desired_thrust_percent * m_voltage_scale);
    const float command = desiredThrustPercentToPwmPercent(compensated_thrust_percent);

    m_output << 0.0f, 0.0f, command, command;

    if (actuate)
    {
        sendActuationCommands(m_output);
    }
}

void GNCController::stop() {

    changeServoAngle(0,0);
    changeServoAngle(1,0);
    changePropPower(0,0);
    changePropPower(1,0);
    m_output << 0.0f, 0.0f, 0.0f, 0.0f;
    sendDisarmingCommands();

}

void GNCController::sendActuationCommands(Eigen::Vector4f actuation_values) {

    float max_prop_power = 100.0f;

    float thrust_top = actuation_values(2); 
    float thrust_bottom = actuation_values(3);

    if (thrust_top > max_prop_power) { thrust_top = max_prop_power; }
    if (thrust_bottom > max_prop_power) { thrust_bottom = max_prop_power; }

    changePropPower(0, (int)thrust_top); 
    changePropPower(1, (int)thrust_bottom); 

    float pitch_servo = actuation_values(0); 
    float yaw_servo = actuation_values(1);

    changeServoAngle(1, pitch_servo); //top servo
    changeServoAngle(0, -yaw_servo); //bottom servo
    // changeServoAngle(0, pitch_angle); //top servo <- this config is for if the board is rotated
    // changeServoAngle(1, yaw_angle); //bottom servo
}


// prop 10 is +y
// prop 11 is -z
void GNCController::changeServoAngle(int servo, float angle_f) { // angle should be -20 to 20
    // RicCoreLogging::log<RicCoreLoggingConfig::LOGGERS::SYS>("Changing Servo Angle: " + std::to_string(angle_f));

    float max_commanded_angle = 15.0f;
    float min_commanded_angle = -15.0f;

    if (angle_f > max_commanded_angle) { angle_f = max_commanded_angle; } 
    else if (angle_f < min_commanded_angle) {
        angle_f = min_commanded_angle;
    }

    angle_f = angle_f * 10; // scale the angle to 0.1 degree = 1 argument degree
    int angle = static_cast<int>(angle_f); // convert to int
    uint8_t des_ser; 

    if (servo == 0) { //bottom servo
        des_ser = 10; 
        angle += 960;
    }
    if (servo == 1) { //top servo
        des_ser = 11; 
        angle += 880;
    }

    SimpleCommandPacket actuate_servo(2, angle); //2 is the fire command
    actuate_servo.header.source_service = 1;
    actuate_servo.header.source = 2;
    actuate_servo.header.destination_service = des_ser;
    actuate_servo.header.destination = 102;
    actuate_servo.header.uid = 0;
    m_networkmanager.sendPacket(actuate_servo);
}

void GNCController::changePropPower(int prop, int power) {
    // RicCoreLogging::log<RicCoreLoggingConfig::LOGGERS::SYS>("Changing Prop Power: " + std::to_string(power));

    uint8_t des_ser; //10 is +y, 11 is -z
    if (power < 0) {
        power = 0; // make sure the power is not negative
    }
    if (prop == 0) {
         des_ser = 10; 
    }
    if (prop == 1) {
        des_ser = 11; 
    }

    //the power is already between 0 and 100 so no need to change

    SimpleCommandPacket actuate_prop(2, power); //2 is the fire command
    actuate_prop.header.source_service = 1;
    actuate_prop.header.source = 2;
    actuate_prop.header.destination_service = des_ser;
    actuate_prop.header.destination = 103;
    actuate_prop.header.uid = 0; //unknown
    m_networkmanager.sendPacket(actuate_prop);

}

void GNCController::sendArmingCommands() {

    armProps();
    armServos();

}

void GNCController::armProps() {
    // RicCoreLogging::log<RicCoreLoggingConfig::LOGGERS::SYS>("Arming Props");
    SimpleCommandPacket arm_prop0(3, 0); //3 here is the arm command
    arm_prop0.header.source_service = 1;
    arm_prop0.header.source = 2;
    arm_prop0.header.destination_service = 10;
    arm_prop0.header.destination = 103;
    arm_prop0.header.uid = 0;
    m_networkmanager.sendPacket(arm_prop0);
    delay(100);
    SimpleCommandPacket arm_prop1(3, 0);
    arm_prop1.header.source_service = 1;
    arm_prop1.header.source = 2;
    arm_prop1.header.destination_service = 11;
    arm_prop1.header.destination = 103;
    arm_prop1.header.uid = 0;
    m_networkmanager.sendPacket(arm_prop1);
}

void GNCController::armServos() {
    // RicCoreLogging::log<RicCoreLoggingConfig::LOGGERS::SYS>("Arming Serovs");
    SimpleCommandPacket arm_alpha(3, 0); //3 here is the arm command
    arm_alpha.header.source_service = 1;
    arm_alpha.header.source = 2;
    arm_alpha.header.destination_service = 10;
    arm_alpha.header.destination = 102;
    arm_alpha.header.uid = 0;
    m_networkmanager.sendPacket(arm_alpha);
    delay(100);
    SimpleCommandPacket arm_beta(3, 0);
    arm_beta.header.source_service = 1;
    arm_beta.header.source = 2;
    arm_beta.header.destination_service = 11;
    arm_beta.header.destination = 102;
    arm_beta.header.uid = 0;
    m_networkmanager.sendPacket(arm_beta);
}

void GNCController::sendDisarmingCommands() {

    disarmServos();
    disarmProps();

}

void GNCController::disarmProps() {
    SimpleCommandPacket disarm_prop0(4, 0); //4 here is the disarm command
    disarm_prop0.header.source_service = 1;
    disarm_prop0.header.source = 2;
    disarm_prop0.header.destination_service = 10;
    disarm_prop0.header.destination = 103;
    disarm_prop0.header.uid = 0;
    m_networkmanager.sendPacket(disarm_prop0);
    delay(100);
    SimpleCommandPacket disarm_prop1(4, 0);
    disarm_prop1.header.source_service = 1;
    disarm_prop1.header.source = 2;
    disarm_prop1.header.destination_service = 11;
    disarm_prop1.header.destination = 103;
    disarm_prop1.header.uid = 0;
    m_networkmanager.sendPacket(disarm_prop1);
}

void GNCController::disarmServos() {
    SimpleCommandPacket arm_alpha(4, 0); //3 here is the arm command
    arm_alpha.header.source_service = 1;
    arm_alpha.header.source = 2;
    arm_alpha.header.destination_service = 10;
    arm_alpha.header.destination = 102;
    arm_alpha.header.uid = 0;
    m_networkmanager.sendPacket(arm_alpha);
    delay(100);
    SimpleCommandPacket arm_beta(4, 0);
    arm_beta.header.source_service = 1;
    arm_beta.header.source = 2;
    arm_beta.header.destination_service = 11;
    arm_beta.header.destination = 102;
    arm_beta.header.uid = 0;
    m_networkmanager.sendPacket(arm_beta);
}

// #include <libriccore/riccoresystem.h>

void GNCController::telemetry_impl(packetptr_t packetptr) {

    SimpleCommandPacket packet(*packetptr);
    //RicCoreLogging::log<RicCoreLoggingConfig::LOGGERS::SYS>("Telemetry_impl called");
	ControllerTelemetryPacket telemetry;

    auto thrust_vector_error_deg = m_pd.getThrustVectorErrorDeg();
    auto f_body = m_pd.getFBody();
    auto pos_err = m_pd.getPositionError();
    auto vel_err = m_pd.getVelocityError();
    auto pos_des = m_pd.getDesiredPosition();
    auto vel_des = m_pd.getDesiredVelocity();
    auto acc_des = m_pd.getDesiredAcceleration();
    auto thrust_world_des = m_pd.getDesiredThrustWorld();
	telemetry.header.type = 108;
	telemetry.header.source = packet.header.destination;
	telemetry.header.source_service = m_serviceID;
	telemetry.header.destination = packet.header.source;
	telemetry.header.destination_service = packet.header.source_service;
	telemetry.header.uid = packet.header.uid; 

    telemetry.q0 =               m_input(0,0);
    telemetry.q1 =               m_input(0,1);
    telemetry.q2 =               m_input(0,2);
    telemetry.q3 =               m_input(0,3);

    telemetry.total_error =       thrust_vector_error_deg(0); // total thrust-axis error, not roll-observable
    telemetry.pitch_error =      thrust_vector_error_deg(1);
    telemetry.yaw_error =        thrust_vector_error_deg(2);

    telemetry.roll_rate_input =  m_input(0,4);
    telemetry.pitch_rate_input = m_input(0,5);
    telemetry.yaw_rate_input =   m_input(0,6);

    telemetry.fx_body =          f_body(0);
    telemetry.fy_body =          f_body(1);
    telemetry.fz_body =          f_body(2);

	telemetry.pitch_output =     m_output(0);
	telemetry.yaw_output =       m_output(1);
	telemetry.thrust_top =       m_output(2);
    telemetry.thrust_bottom=     m_output(3);

    telemetry.m_cmd_y = m_pd.getMcmd()(1); //get the yaw moment command for telemetry
    telemetry.m_cmd_z = m_pd.getMcmd()(2); //get the pitch moment command for telemetry
    telemetry.m_roll_mix = m_pd.getRollMix(); //get the roll mix for telemetry
    telemetry.m_batt = m_batt_V; //get the battery voltage for telemetry
    telemetry.m_voltage_scale = m_voltage_scale; //get the voltage compensation scale for telemetry

    telemetry.m_pos_err_dbg_x = pos_err(0);
    telemetry.m_pos_err_dbg_y = pos_err(1);
    telemetry.m_pos_err_dbg_z = pos_err(2);
    telemetry.m_vel_err_dbg_x = vel_err(0);
    telemetry.m_vel_err_dbg_y = vel_err(1);
    telemetry.m_vel_err_dbg_z = vel_err(2);
    telemetry.m_pos_des_x = pos_des(0);
    telemetry.m_pos_des_y = pos_des(1);
    telemetry.m_pos_des_z = pos_des(2);
    telemetry.m_vel_des_x = vel_des(0);
    telemetry.m_vel_des_y = vel_des(1);
    telemetry.m_vel_des_z = vel_des(2);
    telemetry.m_acc_des_x = acc_des(0);
    telemetry.m_acc_des_y = acc_des(1);
    telemetry.m_acc_des_z = acc_des(2);
    telemetry.m_thrust_world_des_x = thrust_world_des(0);
    telemetry.m_thrust_world_des_y = thrust_world_des(1);
    telemetry.m_thrust_world_des_z = thrust_world_des(2);
    
    telemetry.system_time = millis();
    RicCoreLogging::log<RicCoreLoggingConfig::LOGGERS::CONTROLLER>(telemetry);
	m_networkmanager.sendPacket(telemetry);

}
