icl-rocketry/Ricardo-PickleRick/Firmware/src/Sensors/sensors.cpp

#include "Sensors/sensors.h"

#if HARDWARE_VERSION != 3
#warning "Hardware Version is not 3, INA dep rail monitor will not be initialized!"
#endif

Sensors::Sensors(SPIClass& spi, TwoWire& I2C, Types::CoreTypes::SystemStatus_t& systemstatus)
    : _systemstatus(systemstatus),
      gps(I2C, systemstatus, PinMap::PPS),
      baro(spi, systemstatus, PinMap::BaroCs),
      accelgyro(spi, systemstatus, PinMap::ImuCs_1),
      accel(spi, systemstatus, PinMap::ImuCs_2),
      mag(spi, PinMap::MagCs, systemstatus),
      logicrail("Logic Rail", PinMap::LogicVolt, 8, 1),
      deprail("Deployment Rail", I2C, 0x45),
      lidar(I2C, systemstatus)
{
}

void Sensors::setup(JsonObjectConst config)
{
    using namespace LIBRRC::JsonConfigHelper;
    // default axes order and flip

    std::array<uint8_t, 3> axesOrderICM{1, 0, 2};
    std::array<bool, 3> axesFlipICM{0, 0, 1};

    std::array<uint8_t, 3> axesOrderH3LIS{1, 0, 2};
    std::array<bool, 3> axesFlipH3LIS{1, 1, 1};

    std::array<uint8_t, 3> axesOrderMMC{0, 1, 2};
    std::array<bool, 3> axesFlipMMC{1, 0, 0};

    int logicMaxVoltage = 4200;
    int logicLowVoltage = 3400;
    int logicMinVoltage = 3200;

    setIfContains(config, "LOGIC_MAX_VOLTAGE", logicMaxVoltage, false);
    setIfContains(config, "LOGIC_LOW_VOLTAGE", logicLowVoltage, false);
    setIfContains(config, "LOGIC_MIN_VOLTAGE", logicMinVoltage, false);

    int depMaxVoltage = 28000;
    int depLowVoltage = 3400;
    int depMinVoltage = 3200;

    setIfContains(config, "DEPLOYMENT_MAX_VOLTAGE", depMaxVoltage, false);
    setIfContains(config, "DEPLOYMENT_LOW_VOLTAGE", depLowVoltage, false);
    setIfContains(config, "DEPLOYMENT_MIN_VOLTAGE", depMinVoltage, false);

    gps.setup();
    baro.setup();
    accelgyro.setup(axesOrderICM, axesFlipICM);
    accel.setup(axesOrderH3LIS, axesFlipH3LIS);
    mag.setup(axesOrderMMC, axesFlipMMC);
    logicrail.setup(logicMaxVoltage, logicLowVoltage, logicMinVoltage);
    deprail.setup(depMaxVoltage, depLowVoltage, depMinVoltage);
    lidar.setup();
};

void Sensors::update()
{
    if (hitlEnabled()) { return; }

    accelgyro.update(sensors_raw.accelgyro);
    accel.update(sensors_raw.accel);
    gps.update(sensors_raw.gps);
    baro.update(sensors_raw.baro);
    mag.update(sensors_raw.mag);
    logicrail.update(sensors_raw.logicrail);
    deprail.update(sensors_raw.deprail);
    lidar.update(sensors_raw.lidar);
    sensors_raw.system_time = millis();
};

void Sensors::updateFast()
{
    if (hitlEnabled()) { return; }

    accelgyro.update(sensors_raw.accelgyro);
    accel.update(sensors_raw.accel);
    sensors_raw.system_time = millis();
};

void Sensors::updateSlow()
{
    if (hitlEnabled()) { return; }

    switch (_slowSensorIndex)
    {
        case 0:
            updateGps();
            break;
        case 1:
            updateBaro();
            break;
        case 2:
            updateMag();
            break;
        case 3:
            updateRails();
            break;
        case 4:
            updateLidar();
            break;
        default:
            break;
    }

    _slowSensorIndex = (_slowSensorIndex + 1) % 5;
};

void Sensors::updateGps()
{
    if (hitlEnabled()) { return; }

    gps.update(sensors_raw.gps);
    sensors_raw.system_time = millis();
};

void Sensors::updateBaro()
{
    if (hitlEnabled()) { return; }

    baro.update(sensors_raw.baro);
    sensors_raw.system_time = millis();
};

void Sensors::updateMag()
{
    if (hitlEnabled()) { return; }

    mag.update(sensors_raw.mag);
    sensors_raw.system_time = millis();
};

void Sensors::updateRails()
{
    if (hitlEnabled()) { return; }

    logicrail.update(sensors_raw.logicrail);
    deprail.update(sensors_raw.deprail);
    sensors_raw.system_time = millis();
};

void Sensors::updateLidar()
{
    if (hitlEnabled()) { return; }

    lidar.update(sensors_raw.lidar);
    sensors_raw.system_time = millis();
};

const SensorStructs::raw_measurements_t& Sensors::getData() { return sensors_raw; }

void Sensors::calibrateMag(MagCalibrationParameters magcal) { mag.calibrate(magcal); }


std::function<void(std::unique_ptr<RnpPacketSerialized>)> Sensors::getHitlCallback()
{
    return [this](std::unique_ptr<RnpPacketSerialized> packet_ptr)
    { hitlHandler(std::move(packet_ptr)); };
}

void Sensors::hitlHandler(std::unique_ptr<RnpPacketSerialized> packet_ptr)
{
    // final check that this has only be called in debug mode
    if (!_systemstatus.flagSetOr(SYSTEM_FLAG::DEBUG))
    {
        return;
    }
    // process hitl packet
    switch (packet_ptr->header.type)
    {
        case static_cast<uint8_t>(HITL_PACKET_TYPES::HITL_COMMAND):
        {
            hitlCommandHandler(*packet_ptr);
            return;
        }
        case static_cast<uint8_t>(HITL_PACKET_TYPES::PICKLE_RICK_SENSORS):
        {
            PickleRickSensorsPacket FakeData(*packet_ptr);  // deserialize fake data
            sensors_raw.accelgyro.ax = FakeData.ax;
            sensors_raw.accelgyro.ay = FakeData.ay;
            sensors_raw.accelgyro.az = FakeData.az;
            sensors_raw.accelgyro.gx = FakeData.gx;
            sensors_raw.accelgyro.gy = FakeData.gy;
            sensors_raw.accelgyro.gz = FakeData.gz;

            sensors_raw.accel.ax = FakeData.h_ax;
            sensors_raw.accel.ay = FakeData.h_ay;
            sensors_raw.accel.az = FakeData.h_az;

            sensors_raw.mag.mx = FakeData.mx;
            sensors_raw.mag.my = FakeData.my;
            sensors_raw.mag.mz = FakeData.mz;

            sensors_raw.baro.temp = FakeData.baro_temp;
            sensors_raw.baro.press = FakeData.baro_press;

            // sensors_raw.gps.lat = FakeData.gps_lat;
            // sensors_raw.gps.lng = FakeData.gps_lng;

            sensors_raw.gps.v_n = FakeData.gps_v_n;
            sensors_raw.gps.v_e = FakeData.gps_v_e;
            sensors_raw.gps.v_d = FakeData.gps_v_d;

            sensors_raw.gps.sat = FakeData.gps_sat;
            // sensors_raw.gps.pdop = FakeData.gps_pdop;
            sensors_raw.gps.fix = FakeData.gps_fix;
            sensors_raw.gps.updated = FakeData.gps_updated;
            sensors_raw.gps.valid = FakeData.gps_valid;

            const uint32_t now_us = micros();
            sensors_raw.mag.timestamp_us = now_us;
            sensors_raw.baro.timestamp_us = now_us;
            if (sensors_raw.gps.updated)
            {
                sensors_raw.gps.timestamp_us = now_us;
            }

            hitlUpdateSensorError(FakeData.imu_error, SYSTEM_FLAG::ERROR_IMU);
            hitlUpdateSensorError(FakeData.haccel_error, SYSTEM_FLAG::ERROR_HACCEL);
            hitlUpdateSensorError(FakeData.mag_error, SYSTEM_FLAG::ERROR_MAG);
            hitlUpdateSensorError(FakeData.baro_error, SYSTEM_FLAG::ERROR_BARO);
            hitlUpdateSensorError(FakeData.gps_error, SYSTEM_FLAG::ERROR_GPS);

            sensors_raw.system_time = millis();

            return;
        }
        default:
        {
            return;
        }
    }
}

void Sensors::hitlCommandHandler(RnpPacketSerialized& packet)
{
    switch (CommandPacket::getCommand(packet))
    {
        case static_cast<uint8_t>(HITL_COMMANDS::HITL_ENABLE):
        {
            _hitlEnabled = true;
            RicCoreLogging::log<RicCoreLoggingConfig::LOGGERS::SYS>("HITL Enabled!");
            return;
        }
        case static_cast<uint8_t>(HITL_COMMANDS::HITL_DISABLE):
        {
            _hitlEnabled = false;
            RicCoreLogging::log<RicCoreLoggingConfig::LOGGERS::SYS>("HITL Disabled!");
            return;
        }
        default:
        {
            return;
        }
    }
}

bool Sensors::hitlEnabled()
{
    if (_hitlEnabled && !_systemstatus.flagSetOr(SYSTEM_FLAG::DEBUG))
    {
        _hitlEnabled = false;
    }

    return _hitlEnabled;
}

void Sensors::hitlUpdateSensorError(uint8_t sensor_state, SYSTEM_FLAG flag)
{
    if (sensor_state && !_systemstatus.flagSetOr(flag))
    {
        _systemstatus.newFlag(flag, "hitl raised error");
    }
    else if (!sensor_state && _systemstatus.flagSetOr(flag))
    {
        _systemstatus.deleteFlag(flag, "hitl removed flag");
    }
}
