icl-rocketry/Ricardo-PickleRick/Firmware/include/Estimator/estimator.h

#pragma once

#include <ArduinoJson.h>
#include <string>

#include <libriccore/riccorelogging.h>
#include <librrc/Helpers/jsonconfighelper.h>

#include "Config/types.h"
#include "Config/systemflags_config.h"
#include "Config/timing_config.h"
#include "Sensors/sensors.h"
#include "Sensors/sensorStructs.h"
#include "Sensors/RTKpoller.h"

#include "Estimator/ekf.h"
#include "Estimator/calibrator.h"
#include "Filters/first_order_lowpass.h"

enum class ESTIMATOR_STATE: uint8_t{
    NOMINAL,
    PARTIAL_NO_IMU,
    PARTIAL_NO_IMU_NO_GPS,
    PARTIAL_NO_IMU_NO_BARO,
    PARTIAL_NO_MAG,
    PARTIAL_NO_GPS,
    PARTIAL_NO_GPS_NO_BARO,
    PARTIAL_NO_BARO,
    NO_HOME,
    NOSOLUTION
};

class Estimator{
    public:
        Estimator(Types::CoreTypes::SystemStatus_t& systemstatus);   
        
        void setup();
        void update(const SensorStructs::raw_measurements_t& raw_sensors);

        void calibrate();
        void setHome(); //records the current position as the launch site
        
        bool isHomeSet() { return m_homeSet; };
        const SensorStructs::state_t& getData() { return m_state; };
        void getRTKData(SensorStructs::RTK_t& data);
        std::function<void(packetptr_t)> registerRTK();

        
    private:
        Types::CoreTypes::SystemStatus_t& m_systemstatus;
        SensorStructs::state_t m_state;

        bool m_homeSet;        
        bool m_settingHome; 
        bool m_calibrating;
        bool m_autoHomePending;
        bool m_autoHomeTriggered;
        uint32_t m_gpsLockStartTimeUs;
        uint32_t m_lastGpsDebugTimestampUs = 0;
        uint32_t m_rtkDelayUs = 0;
        Eigen::Quaternionf m_refOrientation;
        
        EKF m_ekf;    
        Calibrator m_calibrator;
        RTKPoller rtk;
        
        FirstOrderLowpass  m_accel_lpf_x;
        FirstOrderLowpass  m_accel_lpf_y;
        FirstOrderLowpass  m_accel_lpf_z;

        FirstOrderLowpass  m_gyro_lpf_x;
        FirstOrderLowpass  m_gyro_lpf_y;
        FirstOrderLowpass  m_gyro_lpf_z;

        uint32_t m_ekfDebugReportTimeUs = 0;
        uint32_t m_ekfDebugPrevStartUs = 0;
        uint32_t m_ekfDebugCount = 0;
        uint32_t m_ekfDebugPeriodCount = 0;
        uint64_t m_ekfDebugPeriodTimeUs = 0;
        uint64_t m_ekfDebugRuntimeUs = 0;
        uint32_t m_ekfDebugMaxPeriodUs = 0;
        uint32_t m_ekfDebugMaxRuntimeUs = 0;

        void updateState();
        void updateAutoHome(const SensorStructs::GPS_t& gps);
        void recordEkfDebugTiming(uint32_t start_us, uint32_t runtime_us);
        bool hasGpsLock(const SensorStructs::GPS_t& gps) const;
        uint32_t rtkDelayUs(const SensorStructs::RTK_t& data, uint32_t now_us) const;
};
