icl-rocketry/Ricardo-PickleRick/Firmware/include/Sensors/RTKpoller.h

#pragma once
#include <librrc/Remote/nrcremotebase.h>
#include "Commands/packets/rtkpacket.h"
#include "Arduino.h"
#include <librnp/rnp_interface.h>
#include "Sensors/sensorStructs.h"
#include <cstdint>

class RTKPoller
{
public:
    RTKPoller() {};
    void setup();
    void update(SensorStructs::RTK_t &data);
    void setHome(Eigen::Vector3f position) {
        x_home = position.x();
        y_home = position.y();
        z_home = position.z();
        m_homeSet = true;
    };
    std::function<void(packetptr_t)> getThisNetworkCallback();
    Eigen::Vector3f getPosition();
    Eigen::Vector3f getPositionRaw();
    bool hasMeasurement() const;
    bool hasFix() const;
    float x_input = 0.0f;
    float y_input = 0.0f;
    float z_input = 0.0f;
    float u_input = 0.0f;
    float v_input = 0.0f;
    float w_input = 0.0f;
    uint8_t fix_quality = 0;
    bool wifi_connected = false;
    uint32_t gnss_time_of_day_ms = 0;
    float x_home = 0.0f;
    float y_home = 0.0f;
    float z_home = 0.0f;
    bool m_homeSet;
private:

    unsigned long m_prev_timestamp = 0;
    bool m_valid = false;
    uint32_t m_timestamp_us = 0;
    static constexpr uint8_t RTK_DEBUG_DIFF_WINDOW_SIZE = 5;
    Eigen::Vector3f m_prevRtkDebugPosition{0.0f, 0.0f, 0.0f};
    float m_rtkDebugDiffWindow[RTK_DEBUG_DIFF_WINDOW_SIZE]{};
    float m_rtkDebugDiffSum = 0.0f;
    uint8_t m_rtkDebugDiffIndex = 0;
    uint8_t m_rtkDebugDiffCount = 0;
    bool m_havePrevRtkDebugPosition = false;

    void handlecommand(packetptr_t packetptr);
    bool hasFreshMeasurement(uint32_t now_us) const;

    RTKPacket rtkdata;
};
