icl-rocketry/Ricardo-PickleRick/(commit log)

2022-02-14 added pickle rick
    [IMU.kicad_sch, Nukes.kicad_sch, PickleRick.kicad_pcb, PickleRick.kicad_sch, gps.kicad_sch, power.kicad_sch, radio.kicad_sch, usb_uart.kicad_sch]
2022-02-15 Added LMR14050 buck converter to pickle rick
    [Nukes.kicad_sch]
2022-03-01 Annotated schematic & done layout for buck converter
    [PickleRick.kicad_pcb, PickleRick.kicad_sch]
2022-03-20 first full layout of pickle complete
    [Nukes.kicad_sch, PickleRick.kicad_pcb, PickleRick.kicad_sch, PickleRick.step, usb_uart.kicad_sch]
2022-03-22 pickle layed out
    [Nukes.kicad_sch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]
2022-03-28 pickle update
    [PickleRick.kicad_pcb, PickleRick.kicad_sch, power.kicad_sch, usb_uart.kicad_sch]
2022-03-28 pickle ready for review
    [PickleRick.csv]
2022-03-28 removed some vias to conform to jlcpcb 100k holes per sqm
    [PickleRick-B_Cu.gbr, PickleRick-B_Mask.gbr, PickleRick-B_Paste.gbr, PickleRick-B_Silkscreen.gbr, PickleRick-Edge_Cuts.gbr, PickleRick-F_Cu.gbr, PickleRick-F_Mask.gbr, PickleRick-F_Paste.gbr]
2022-03-28 changed autoprogrammer cap values
    [PickleRick.kicad_sch]
2022-04-01 final changes to pick rick
    [PickleRick.kicad_pcb, PickleRick.kicad_sch, usb_uart.kicad_sch]
2022-04-07 switched vspi and hspi labels so they are consistent with documentation
    [IMU.kicad_sch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]
2022-06-27 added i2c comms to mag class as mag seems to not work over spi, currently debugging this.
2022-07-05 migrated python_backend to its own repo, sperated flight controller code and groundstation gateway code
2022-11-27 working on v2
    [IMU.kicad_sch, PickleRick.kicad_pcb, PickleRick.kicad_sch, can.kicad_sch, gps.kicad_sch, power.kicad_sch, usb-uart.kicad_sch, usb_uart.kicad_sch]
2022-12-12 v2 time
    [IMU.kicad_sch, Nukes.kicad_sch, PickleRick.kicad_sch, can.kicad_sch, gps.kicad_sch, power.kicad_sch, radio.kicad_sch, usb-uart.kicad_sch]
2022-12-23 first layout of s3
    [PickleRick.kicad_pcb]
2023-01-01 Conitnued with v2, NB pinout of external sd card has changed!!! Chest needs to be updated before manufacturing!!!
    [Nukes.kicad_sch, PickleRick.kicad_sch, power.kicad_sch, usb-uart.kicad_sch]
2023-02-11 made more progress
    [Nukes.kicad_sch, PickleRick.kicad_pcb, PickleRick.kicad_sch, usb-uart.kicad_sch]
2023-02-12 all components basically routed and fitted onto pickle v2
    [Nukes.kicad_sch, PickleRick.kicad_pcb, PickleRick.kicad_sch, power.kicad_sch]
2023-02-12 minor updates
    [PickleRick.kicad_pcb]
2023-02-25 converted to kicad 7
    [PickleRick.kicad_pcb]
2023-03-18 changed bb and power side
    [IMU.kicad_sch, Nukes.kicad_sch, PickleRick.kicad_pcb, PickleRick.kicad_sch, can.kicad_sch, gps.kicad_sch, power.kicad_sch, radio.kicad_sch]
2023-03-31 some updates?
    [power.kicad_sch]
2023-04-10 did layout of buck kinda. 90% there
    [PickleRick.kicad_pcb, power.kicad_sch]
2023-04-10 initial layout complete
    [power.kicad_sch]
2023-04-11 layout almost complete
    [PickleRick.kicad_pcb, PickleRick.kicad_sch, power.kicad_sch]
2023-04-15 almost done
    [PickleRick.kicad_pcb]
2023-07-07 imagine fixing your DRC errors
    [PickleRick.kicad_pcb, PickleRick.kicad_sch]
2023-07-08 fixed some stuff
    [PickleRick.kicad_pcb]
2023-07-21 new standardized directory setup
    [IMU.kicad_sch, Nukes.kicad_sch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]
2023-07-26 added firmware
    [ricpart.csv]
2023-07-26 rewrote batttery class as voltage monitor
2023-07-27 converting sensors to new framework
2023-08-08 fixing the arduino library, aka leave my spi bus alone
2023-08-11 fixed the dps310 driver
    [main.cpp]
2023-08-11 fixed buzzer issues and removed serial print from mmc5983ma library
    [mmc5983ma.cpp, system.cpp]
2023-08-12 fixed battery reading
2023-08-19 acceloremeter calibration
2023-08-22 swapped command ids for mag and high-g accel. Tested with hitl, seems to crash if hitl poll rate is too high
    [commands_config.h, main.cpp, sensors.cpp]
2023-08-25 added saving dps calibration values to nvs
2023-08-28 mag axes correct inshaallah
    [mmc5983ma.cpp]
2023-09-05 3D model directory
    Hopefully now if you configure paths in the 3d model section to your iclrhw 3d model directory, all 3d models should load
    [PickleRick.kicad_pcb]
2023-09-05 black edition ordering stuff
    [PickleRick.kicad_pcb, PickleRick.kicad_sch, bom.csv, designators.csv, positions.csv, power.kicad_sch, usb-uart.kicad_sch]
2023-09-05 3D update
    [IMU.kicad_sch, Nukes.kicad_sch, PickleRick.kicad_pcb, PickleRick.kicad_sch, can.kicad_sch, gps.kicad_sch, power.kicad_sch, radio.kicad_sch]
2023-09-23 fixed deadlock in storage stuff
    [sdfat_file.cpp, sdfat_store.cpp]
2023-09-27 fixed no sd bug
    [system.cpp]
2023-10-11 added per sensor config of axes, needs checking tho
2024-01-06 fires once, still need to fix things
    [system.cpp, system.h]
2024-03-07 updated arduino
2024-03-12 fixed arduino lib issues
    [commands_config.h, estimator.cpp, sensorStructs.h]
2024-03-12 updated esp32 env too
2024-04-13 identified bugs with how axis defnitions are taking place... madgwick filter seems to have a funky axis defnition aswell, need to investigate further. Fixed mag calibnrations not saving
    [estimator.cpp, h3lis331dl.cpp, icm_20608.cpp, mmc5983ma.cpp, sensors.cpp, system.cpp, system.h]
2024-04-13 Modified madgwick to NED, reverted Kiran's axes changes on v3-DEV
    [h3lis331dl.cpp, icm_20608.cpp]
2024-04-13 Set lora transmit power too 100mW
2024-04-13 Swapped lin accel and imu calibration
    [estimator.cpp, h3lis331dl.cpp, icm_20608.cpp]
2024-06-22 changed arduino-Lora to iclr fork
2024-07-02 added 10km ekf cut off for barometer
2024-07-06 udated pca9534 driver to write shadows to i2c deivce on setupo
2024-07-21 added new radio mode to try debug the radio driver
2024-07-22 v3 hardware start
    [IMU.kicad_sch, Nukes.kicad_sch, PickleRick.kicad_sch, can.kicad_sch, gps.kicad_sch, low_profile_minifit.kicad_pcb, low_profile_minifit.kicad_sch, power.kicad_sch]
2024-08-15 more hardware updates
    [Nukes.kicad_sch, PickleRick.kicad_pcb, PickleRick.kicad_sch, abus.kicad_sch, power.kicad_sch]
2024-08-16 hardware update
    [PickleRick.kicad_pcb]
2024-08-17 more updates to hardware
    [PickleRick.kicad_pcb]
2024-08-17 added cont and firing leds
    [Nukes.kicad_sch]
2024-08-17 hardware complete
    [PickleRick.kicad_pcb, bom.csv, designators.csv, positions.csv]
2024-08-17 updated antenna trace widths
    [PickleRick.kicad_pcb]
2024-08-17 added planes
    [PickleRick.kicad_pcb]
2024-08-17 fioxed keep out for efuse
    [PickleRick.kicad_pcb]
2024-08-18 replaced efuse with ina219
    [PickleRick.kicad_pcb, PickleRick.kicad_sch, gps.kicad_sch, power.kicad_sch]
2024-09-01 updated hardware with current limitng resistors on pwm outputs
    [Nukes.kicad_sch, PickleRick.kicad_pcb]
2024-09-02 updated pickle firmware with new servo hal, finally enablign local servos on pickle!
2024-09-02 hardware updates
    [power.kicad_sch]
2024-09-04 added contiutiy detection in the event handler for switch based triggers
2024-09-09 Ordering v3
    [PickleRick.kicad_pcb, bom.csv, designators.csv, gps.kicad_sch, positions.csv, power.kicad_sch]
2024-09-20 added v3 pin map
2024-10-01 added bug fixes and ereg shutting on shutdown
    [system.cpp]
2024-10-01 fxied can bus erase issue
2024-10-04 sd card log 32 bit overflow fix
    [system.cpp]
2024-12-22 updated estimator rocket orientation with correct maths
    [estimator.cpp]
2025-01-12 rewriting radio class to support interrupts
2025-01-14 updated ledc api
2025-01-14 updated ini with new framework
2025-01-14 updated arduino to 3.1.1
2025-01-18 BREAKING CHANGE ublox max m8q no longer supported
    [max_m10s.cpp]
2025-02-06 Fixed outdated LEDC api call in TunezHandler
2025-02-13 Hardware folder cleanup and gitignore
    [PickleRick-B_Cu.gbr, PickleRick-B_Silkscreen.gbr, PickleRick-Edge_Cuts.gbr, PickleRick-F_Cu.gbr, PickleRick-F_Silkscreen.gbr, PickleRick-In1_Cu.gbr, PickleRick-In2_Cu.gbr, PickleRick-NPTH.drl]
2025-02-13 Adding some 3d models
    [IMU.kicad_sch, Nukes.kicad_sch, PickleRick.kicad_pcb, PickleRick.kicad_sch, abus.kicad_sch, can.kicad_sch, gps.kicad_sch, power.kicad_sch]
2025-02-14 Full v3 Pickle 3d model
    [PickleRick.kicad_pcb, PickleRick.kicad_sch, gps.kicad_sch]
2026-04-02 removed arduino dps3xx package
2026-04-03 sensor drivers reformatted
2026-04-06 position ekf implemented, still need tuning for better quality and less drift
    [calibrator.cpp, calibrator.h, dps368.cpp, ekf.cpp, ekf.h, estimator.cpp, estimator.h]
2026-04-13 recalibrated servo angles
2026-04-19 quaternions no longer cooked
    [GNCController.cpp, PDController.cpp, PDController.h, estimator.cpp]
2026-04-23 added low pass filter to accelerometer and gyro
2026-04-30 Added in thrust battery voltage scaling
2026-05-02 lidar implemented, first draft of position controller also implemented
2026-05-20 GPS velocity straight to ekf, fixed GPS bug where _pvt.valid stays true forever after the first byte
    [PDController.cpp, PDController.h, ekf.cpp, ekf.h, max_m10s.cpp]
2026-05-20 custom throttle profile
2026-05-28 custom throttle profile with final scaling values for voltage and PWM linearisation
2026-06-07 RTK added, not working, future me problem
    [ControllerTelemetryPacket.cpp, ControllerTelemetryPacket.h, GNCController.cpp, PDController.cpp, PDController.h, RTKpoller.cpp, RTKpoller.h, calibrator.cpp]
2026-06-12 RTK working, revert to here if nothing else is working
    [PDController.cpp, RTKpoller.cpp, RTKpoller.h, ekf.cpp, ekf.h]
2026-06-13 RTK time stamping, now running at 20hz
2026-06-16 Added GPS retrodiction, changed retrodiction timing to be based on PPS interrupt, fixed UTC to GPS time bug, added serial print debug config file
    [ControllerTelemetryPacket.cpp, ControllerTelemetryPacket.h, GNCController.cpp, PDController.cpp, PDController.h, RTKpoller.cpp, RTKpoller.h]
2026-06-23 fixed magnetometer calibration, added set home safety feature, added EKF start up calib for orientation
    [GNCController.cpp, PDController.cpp, PDController.h, calibrator.cpp, debug_config.h, ekf.cpp, ekf.h]
2026-06-23 added autopilot landing, added multiple trajectories, tuned controller, made magnetometer only affect the heading (roll), not pitch and yaw
2026-06-24 cleaned up schematic and bom
    [IMU.kicad_sch, Nukes.kicad_sch, PickleRick.kicad_pcb, PickleRick.kicad_sch, abus.kicad_sch, can.kicad_sch, gps.kicad_sch, power.kicad_sch]
2026-06-24 updated resistors w cap footprints
    [PickleRick.kicad_pcb, abus.kicad_sch, power.kicad_sch]
